ShibainuQAQ/FPGA/开发过程记录.md

# 开发过程记录

> 本作品从零开始推进，**全部开发过程以 Git 提交留痕**：
> **Gitee 主仓库：<https://gitee.com/shibainu1145/fpga>**（`master` 分支；2026-10-08 至 2026-10-31 共 **140 余次提交**，本文件本身也是一次提交）。
> 克隆后执行 `git log --oneline --date=short --pretty='%ad %s'` 即可逐条核对下文的每一次问题定位、方案迭代与实测修正。
> 本文件是这些提交的**按日期摘要**，方便快速浏览；两者内容一致，无事后美化。

---

## 1. 项目概况

| 项 | 内容 |
| --- | --- |
| 作品 | 基于 Zynq-7020 的全数字控制同步 Buck 变换器 |
| 主电路 | 24 V 输入 → 5 V / 0–3 A 输出，200 kHz 同步 Buck |
| 数字控制 | FPGA 内 DPWM（200 MHz，分辨率 5 ns）、12 位 ADC 采样、2P2Z 数字补偿、两级保护 |
| 开发周期 | 2026-10-08 ～ 2026-10-31（24 天，其中 14 天有提交，合计 140 余次） |
| 交付物 | 技术文档（201 段 / 5 表 / 25 图 / 33 页 PDF）、原理图与 PCB、BOM/Gerber/网表、FPGA 工程、演示视频 |

开发节奏是「**当天有结论就当天提交**」，所以提交密度不均匀：设计和审图阶段一天几十次，等板、等元件、现场联调的日子没有提交——那些天的工作成果体现在次日的文档与实测数据里。

---

## 2. 按日期总览

| 日期 | 提交数 | 当天主题 |
| --- | ---: | --- |
| 10-08 | 5 | 工程启动：选题冻结、ALINX AX7020 开发板锁定、XDC 模板与接口表 v1.0 |
| 10-09 | 25 | 功率级分区设计：A 区（输入滤波/保护）、B 区（辅助电源）、C 区（Buck 功率级）、D 区（栅极驱动）逐区元件清单与引脚级接线 |
| 10-10 | 60 | 原理图逐区绘制（E～I 区）+ 网表/BOM 逐项校验，12 次导出复核 |
| 10-11 | 8 | 铜宽分层、地平面分域、元件分层规范、BOM 定案、投板前检查 |
| 10-12 | 5 | 定板下单（**120.19 × 86.28 mm**）、报告骨架按竞赛模板生成 |
| 10-14 | 3 | 报告章节审阅、OVP 阈值标定表、DPWM 分辨率表述修正、FPGA 框图与 ADC 采样相位图 |
| 10-16 | 2 | AD9226 实测操作单、反馈分压比回归 0.39 |
| 10-17 | 1 | ADC 实测灵敏度判定、反馈极性与 OVP 瞬态取舍 |
| 10-18 | 5 | 板上电交接单（含停止条件）、整板极性复核（**4 只电解反装**）、上电过载诊断、报告插图 |
| 10-19 | 7 | 仓库公开化整理（01–05 目录）、闭环联调准备清单、提交倒排计划 |
| 10-26 | 7 | 实测数据集中回灌报告：死区 200 ns、ADC 416 码/V、fc/PM 锁定、ILA 死区图、两份测试台差异定位、**撤回对 9.4 V 的误判** |
| 10-29 | 6 | 工作区迁移、报告新增 §3.6「实测暴露的不足与下一版改进」、图 3-9 按证据删减 |
| 10-30 | 11 | README 指标口径对齐、25 张图正文引用补齐、改板清单 v3、开发留痕入口；**完整 RTL 与上板 XDC 入库**（四模块 + 24 条引脚约束）、报告 OVP/PS 侧口径更正 |
| 10-31 | 1 | **Vivado IP 配置入库**（`clk_wiz_0` / `ila_0` 的 `.xci` + ILA 重建脚本，路径改为可参数化）、README 依赖说明随之更新 |

> 无提交的日子（10-13、10-15、10-20～10-25）是等板/等元件与现场整机联调期，文档整理集中在有结论时一次提交，不是空转。

---

## 3. 阶段与关键节点

### 阶段一：方案冻结与功率级分区设计（10-08 ～ 10-09，30 次提交）
- 锁定主电路拓扑（同步 Buck）、开发板（AX7020）、引脚与网络命名契约（`24V_BUS`/`GND`/`HO`/`LO`/`SW` 等），接口表冻结 v1.0。
- 把整板拆成 A～I 九个功能区，逐区产出**元件清单 + 引脚级接线 + 布局要点**，而不是先画图后补文档。
- 关键决策：NMOS 连接拓扑按引脚级（含体二极管、散热片电位、热环路）画清楚后才动原理图；栅极驱动选 IR2110（DIP-14，含自举）。

### 阶段二：原理图绘制、网表校验与 BOM 定案（10-10 ～ 10-11，68 次提交）
- 每画完一个区就**导一次网表做程序化校验**（单脚网、悬空元件、元件数与网数），校验通过才关闭该区。
- 期间拦下两类致命错误（见 §4 案例 1、2），并把「导出后必跑校验清单」固化为流程。
- BOM 逐行核对 LCSC 编号与封装，修掉 9 个料号错列、2 个型号错件、R4–R16 漏填等问题。
- 10-12 定板下单，尺寸 120.19 × 86.28 mm。

### 阶段三：报告骨架与设计文档（10-12 ～ 10-17，11 次提交）
- 技术文档直接**从竞赛模板生成**（页眉 Logo、页脚页码、样式全部继承），后续每次重建都不破坏版心纪律。
- 报告插图由「清单驱动」：脚本按图号匹配候选文件名，缺图留红字占位，不出现「图文不符」。
- 10-14 修正一处表述错误：DPWM 分辨率写作 5 ns 而非 20 ns；补 FPGA 内部框图与 ADC 采样相位图。

### 阶段四：板上电、排故与闭环准备（10-18 ～ 10-19，12 次提交）
- 焊前做**全板极性复核**，查出 4 只电解电容封装极性与原理图相反（案例 3）。
- 上电按交接单执行，遇到恒功率特征的过载（案例 4），定位到 3V3 供电冲突。
- 输出闭环联调准备清单，明确唯一缺口是电压采样缓冲（案例 8 的前置）。

### 阶段五：整机闭环联调与实测（10-20 ～ 10-25，仓库静默）
- 这一周在现场完成闭环上板：软启动、2P2Z 数字补偿、两层保护、ILA 与示波器双通道实测。
- 数据没有当场上库，10-26 一次性回灌（案例 5、6、7）。

### 阶段六：实测数据回灌与报告定稿（10-26 ～ 10-31，25 次提交）
- 把实测结果与仿真、解析模型三方对齐：死区 200 ns、ADC 416 码/V、fc 6.98 kHz、PM 82.6°（设计）/ 83.9°（仿真）/ 83.5°（解析）。
- 建立「四套冲突数字」的处理规则：**以能给出测量方法与波形的那个数为准**，其余标注口径或直接删除。
- 报告新增 §3.6 专章写「实测暴露的不足与下一版改进」，不做选择性披露。
- 10-29 图 3-9（输出纹波与负载阶跃）在数据审查后被删除——理由见案例 9。
- 10-30 **完整 RTL 与上板 XDC 补入仓库**：四个模块（DPWM / ADC 接口 / 2P2Z / 顶层）按上板原始文件入库，`xvlog` 编译通过、DPWM 五项回归全过；`dpwm_top.xdc` 24 条引脚约束覆盖顶层全部 13 个端口。同时把「OVP 动作点未实测」「PS 侧监控本版未实现」两处过度声称改回事实表述。
- 10-31 **Vivado IP 配置补入仓库**：`clk_wiz_0`（50 → 200 MHz）与 `ila_0`（6 探针 / 深度 2048）的 `.xci` 以及 ILA 重建脚本 `build_ila.tcl` 入库，脚本的工程路径改为「命令行参数 → 环境变量 → 当前目录」三级回退，不再是某个人的本机绝对路径。至此**仓库自带可综合所需的全部输入**：RTL + 引脚约束 + IP 配置 + 回归测试台。

---

## 4. 典型问题与解决（均可在提交历史中查到原文）

**案例 1：网表里 24 V 与 GND 被短接（10-10 00:37）**
一次导出后程序化校验报「24V 与 GND 合并」——铜箔层实为死短路。原因是一个电源网络被误接到地网络。
处置：修正接法，并把「导出后必查电源—地是否短接」列为硬性检查项，此后每次导出必跑。

**案例 2：自举电容被短路，MOSFET 无法开通（10-10 14:25）**
IR2110 的 VB 脚与 SW 脚被画成同一网络，自举电容两端等电位，浮地驱动失效。
处置：拆出独立 `VB` 网络（4 个成员：自举二极管阴极、自举电容正极、VB 脚、无其他连接），并复核自举二极管阳极接 12 V。

**案例 3：4 只电解电容封装极性与原理图相反（10-18 21:28）**
焊前逐颗比对丝印与封装库，发现 4 只电解电容的封装极性画反。
处置：全板极性复核表 + 焊装顺序改为「先极性件后非极性件」；报告把这条写进「不足与改进」。

**案例 4：上电即过载，特征指向 3V3 冲突（10-18 18:04）**
恒功率特征的过流说明不是短路而是负载异常，最终定位到 3V3 由板上与外部同时供给形成对冲。
处置：明确 3V3 为**板输入**，补电源方向表与两条供电规则。

**案例 5：死区从 20 ns 改成 200 ns（10-26）**
最初按「越小越好」取 20 ns，实测开关瞬间出现约 300 mA 直通电流。
处置：死区 40 个 5 ns 计数 = **200.0 ns**（ILA 读数 40×5 ns 与示波器 200.000 kHz 双证据互证），并把「死区不得小于 200 ns」写进改板清单与 RTL 约束。

**案例 6：保护响应时间口径被拆成三段（10-26 20:50）**
早期把保护响应笼统写成「10–15 ns」，与实测的端到端约 1.0 µs 矛盾。
处置：拆成 **逻辑封波 2 拍 = 10 ns → 数字链路 58 ns → 含 1 µs 数字滤波的端到端 ≈1.0 µs → 驱动级再 +95~120 ns** 四段，各自给测量条件。

**案例 7：撤回对「9.4 V 启动过冲」的误判（10-26 22:48）**
曾把一份仿真 CSV 的 9.37 V 峰值当成真实启动过冲。复核发现该 CSV 的软启动参数有误（**40 µs 就到 5 V**，是设计的 16 倍快），该数据不能用来画启动过程。
处置：公开撤回该结论；改用示波器实测启动波形（峰值 **6.56 V**，+24 %），并新增图与表行记录。这是本项目「数据自纠」的标志性一次。

**案例 8：反馈采样阻抗不匹配（10-17 ～ 10-18）**
12 位 ADC 模块输入阻抗 50 Ω，而分压网络戴维南等效约 10.6 kΩ，直接相连会把 1.70 V 拉到 0.047 V。
处置：本版临时改为板外 220 Ω / 2.2 kΩ 分压（比值 ≈0.2017，零点 2048，实测 REF_CODE 2453）；下一版加单位增益跟随器。

**案例 9：删掉一张「凑不出来」的图（10-29 16:58）**
原计划的图 3-9「输出纹波与负载阶跃响应」无法用现有数据画出：仿真导出步长 5 µs（每个开关周期仅 1 点），**不足以还原 200 kHz 纹波**；负载阶跃数据里还含阶跃首点的数值伪迹。
处置：直接删除该图并整体前移图号，纹波只用实测值（60 mV，短地弹簧测量法）+ 表格表述。宁缺一张图，不留一处图文不符。

---

## 5. 最终口径速查（与报告、答辩一致）

| 项 | 数值 |
| --- | --- |
| 开关频率 / 周期 | 200.00 kHz / `PERIOD_CY` = 1000（200 MHz 计数） |
| DPWM 分辨率 / 死区 | 5 ns；死区 40 计数 = **200.0 ns**（高侧脉宽 980 ns、低侧 3980 ns） |
| 占空比（三工况） | 闭环带载 2 Ω **22.6~23.0 %**；闭环空载 **16.8 %**；开环 15.6 % / 76.6 % |
| ADC | AD9226，12 位，**416 码/V**，零点 2048，`REF_CODE` 2453，板外分压比 0.2017 |
| 数字补偿 | 2P2Z，Q14 定点；B0=624、B1=−1121、B2=504、A1=−22272、A2=+5888 |
| 环路 | fc ≈ 6.98 kHz；PM 82.6°（设计）/ 83.9°（仿真）/ 83.5°（解析，图 2-15） |
| 保护 | 逻辑封波 10 ns → 数字链路 58 ns → 含 1 µs 滤波端到端 ≈1.0 µs → 驱动 +95~120 ns |
| 稳态实测 | 5.00 V，ADC 码 2453 与 `REF_CODE` 一致（误差 0 码），纹波 60 mV，空载输入电流 46 mA |
| 时序 | WNS +0.581 ns |
| 仿真 | 稳态 4.9946 V、纹波 14.9 mV；负载 0.7→3 A 跌落 15.3 %、3→0.3 A 过冲 20.2 %，恢复 4.0 / 2.5 ms |

---

## 6. 已知不足（如实披露）

1. **启动过冲**：实测峰值 6.56 V（+24 %），超出 OVP 设计参考 5.76 V；因尖峰短于 1 µs 数字滤波窗未触发保护。根因是软启动只做参考码线性斜坡、无占空比斜率限制。
2. **OVP 动作点未实测**：分压比换算的设计目标 5.76 V，实际动作点本版从未测量（流传的「6.34 V」是按基准与分压比反推，不是实测）；下一版逐台实测后重标定分压电阻，并把 OVP 阈值 / ADC 满量程 / OTR 三项联动校核。
3. **负载阶跃仅有仿真结果**：实测负载阶跃未完成，报告按「仅仿真」标注。
4. **效率与温升未测**：功率通路存在端子与铜箔线损（等效 ≈0.19 Ω），是效率的主要瓶颈，已列入下一版改板。
5. **硬件 12 条改进**：完整清单与优先级见 `05-硬件与采购/改板清单-v3-20261030.md`（该目录随 Gitee 主仓库留痕，公开交付快照不含；P0 四条：电压采样加跟随器、取样点移负载侧、输出端子与铜宽、电解封装极性）。

---

## 7. 如何核对与复现

```bash
git clone https://gitee.com/shibainu1145/fpga.git
cd fpga
git log --oneline --date=short --pretty='%ad %s'      # 140 条提交，即本文件的数据来源
git log --stat                                        # 看每次提交改了哪些文件
```

- 报告生成：`04-技术文档/工具/生成脚本.py`（重建 docx）
- 报告校验：`04-技术文档/工具/校验.py`（版心、插图宽度、表宽、页眉页脚、章节完整性）
- 硬件布局图生成：`05-硬件与采购/工具/`（随 Gitee 主仓库留痕）
- EDA 导出校验：`03-EDA导出/工具/`

技术文档、原理图素材、BOM、Gerber、网表、FPGA 工程与本记录同版本提交，可直接对照阅读。
