ShibainuQAQ/FPGA/01-项目说明/01-作品简介.md

# 作品简介

**作品名称**：基于 FPGA 的全数字控制同步 Buck 降压电源

**一句话简介**：面向精密仪器低压供电轨（传感器与模拟前端的数字预稳压级）的 24 V→5 V/3 A 全数字同步 Buck 变换器，调制、采样、补偿与保护全部由 FPGA 可编程逻辑实现。

---

## 一、作品概述（约 400 字）

本作品面向“对供电稳定性要求高、单路功率在数十瓦以内”的精密低压负载，作为其**数字预稳压级**。这类负载（例如半导体制造与精密测量装备中传感器、模拟前端的供电轨）通行“开关前级＋线性后级”的两级架构：开关级负责效率、瞬态响应与故障保护，后级以 π 型滤波与 LDO 把纹波压到毫伏级，直流精度由电压基准决定。

本作品以 AMD Zynq-7020 的可编程逻辑（PL）为核心，设计并实现一台 24 V 输入、5 V/0–3 A 输出的全数字控制同步 Buck 变换器。与“FPGA 仅作 PWM 发生器”的常见做法不同，本作品把开关频率、死区、保护、采样时序与闭环补偿全部置于 PL 内：200 MHz 时钟域产生 200 kHz 互补 PWM（时间分辨率 5 ns、占空比步进 0.1%），并插入 200 ns 数字死区；输出电压经分压、电感电流经 10 mΩ 分流电阻与电流检测放大器（50 V/V）调理后，由 12 位 AD9226 以 2 MHz 与 PWM 周期严格同步地在“安静窗”内采样，送入片内 2P2Z 数字补偿器构成闭环；过流与过压由硬件比较器检测，FPGA 的数字链路以 58 ns 固有延迟（含 1 µs 数字滤波后端到端约 1.0 µs）逐周期封锁 PWM 并闩锁至人工复位。

作品的价值不仅在功能实现，更在于**可验证的工程方法**：原理图阶段以导出网表逐网络逐引脚核对（终版 51 网络、零单脚网络、零悬空元件），打板前检查层叠与孔位，装配前核对全部有极性器件；并搭建“被控对象—ADC—采样接口—补偿器—DPWM”的端到端 RTL 闭环仿真，据其结果为反馈通道定标。上板后闭环输出 5.00–5.01 V、稳态误差 0 码、纹波 60 mV（短地弹簧实测）；启动过冲 6.56 V 等不足亦如实记入报告。全程 24 V 以下低压验证，兼顾安全与可重复性。

---

## 二、主要技术指标

| 项目 | 指标 |
|---|---|
| 输入 / 输出 | 24 V → 5 V / 0–3 A（15 W） |
| 开关频率 | 200 kHz（周期 5000 ns；实测 200.00 kHz） |
| DPWM 时间分辨率 | **5 ns**（占空比步进 0.1%） |
| 数字死区 | **200 ns**（40 × 5 ns，高低侧双向，计数器统一产生） |
| 保护响应 | 数字链路 **58 ns**（无滤波）；含 1 µs 数字滤波后端到端 **≈1.0 µs**；驱动级再叠加 95~120 ns |
| 保护机制 | 硬件 OCP/OVP 比较器 + 逐周期封锁 + 故障闩锁 |
| ADC | AD9226 12 bit / 65 MSPS，2 MHz 与 PWM 同步采样；实测灵敏度 **416 码/V**、零点 2048 |
| 电流采样 | 10 mΩ 分流 + INA180A2（50 V/V）= 0.5 V/A |
| 电压采样 | 本版板外 220 Ω／2.2 kΩ，分压比 **0.2017**、参考码 2453（板内 R7/R8/R9 可调 0.25–0.40，下一版启用） |
| 控制算法 | 2P2Z 数字补偿器（Q14 定点、10 拍流水 MAC） |
| 环路指标 | fc **6.99 kHz**、PM **83.5°**（解析模型，Td 7.5 µs / f0 6.79 kHz / Q 3.91） |
| 闭环仿真 | 稳态 4.9946 V、纹波 14.9 mV、负载跌落 15.3 %、过冲 20.2 %、恢复 4.0／2.5 ms |
| 闭环实测（上板） | 5.00–5.01 V、ADC 码 2453 与参考码一致（**误差 0 码**）、纹波 60 mV、带载 2 Ω 占空比 22.6~23.0 % |
| 启动过冲（实测） | 峰值 **6.56 V**（+24 %），持续时间短于 1 µs 滤波窗口未触发保护，2 ms 内恢复 5 V |
| 功率板 | 120.19 × 86.28 mm、2 层、1 oz、4 × M3 |

---

## 三、主要特点

1. **全数字控制**：调制、死区、保护、采样时序与补偿全部由 PL 实现，参数可通过 RTL 调整，
   重复性好、不受温漂影响。
2. **采样相位与功率级对齐**：电流采样仅在低边管导通期间有效，采样点由 RTL 精确落在该窗口内，
   并避开开关瞬态。
3. **三层保护**：硬件比较器快速检测、FPGA 逐周期封波（数字链路 58 ns，含 1 µs 滤波约 1.0 µs）、
   故障闩锁与人工复位，在功率器件受损之前切断驱动。
4. **仿真驱动设计**：以端到端 RTL 闭环仿真校核环路，并据此纠正了采样通道的关键假设
   （ADC 灵敏度实测 **416 码/V**、零点恰为 **2048**），重新核定了反馈余量与补偿器定标。
5. **面向开关电源的板级纪律**：开关环路面积最小化、功率地与信号地分域单点星形汇接、
   电流采样开尔文连接、按载流分级的铜宽与多过孔换层。
6. **面向精密供电的工程定位**：以“开关前级＋线性后级”两级架构对接传感器与模拟前端供电轨，
   实测不足（纹波 60 mV、启动过冲 +24 %、负载阶跃恢复 4 ms）与改进方向完整记录于报告 §3.6。
