ShibainuQAQ/FPGA/03-EDA导出/网表核对-20261009.md

# 网表核对记录 · A/B/C 三区（2026-10-09 23:41）

> 源文件：`Netlist_DC-DC电源_2026-10-09.tel`（立创EDA 导出，Telesis 格式）
> 方法：**逐网络、逐引脚**对照《接口表① 信号接线表 v1.0》+ 各区要点文档（比看截图可靠）
> **结论：✅ A/B/C 三区通过**——24V 输入、两级辅助电源（12V/5V）、Buck 功率级全部闭环

---

## 一、关键网络逐条核对

| 网络 | 网表成员 | 判定 |
|---|---|---|
| `24V` | C1.1 C2.1 C3.2 C4.2 C11.2 C23.2 D1.2 LED1.2 Q1.2 U1.1 | ✅ 输入电容组 + 防反输出 + 两只 IC 输入 + 上管漏极 |
| **半桥 `SW`** | L3.1 Q1.3 Q2.2 R_gs1.1 | ✅ 上管源 / 下管漏 / 电感 / 上管下拉，一处不错 |
| `12V` | C5.2 C6.2 C9.2 C12.2 C14.2 L1.2 LED2.2 U1.4 U2.1 | ✅ 含 U1.FB、U2.VIN（级联）；**不含任何二极管** |
| `5V` | C7.2 C8.2 C10.2 C13.2 L2.2 LED3.2 U2.4 | ✅ 含 U2.FB；**不含任何二极管** |
| `VOUT` | C15.2 C16.2 C17.2 C18.2 C19.2 C20.2 L3.2 | ✅ 与 `5V` 完全独立（未混网） |
| `GND` | 40 个引脚（J1.2 / R_shunt.1 / U1·U2 的 3·5·6 脚 / 两只续流管阳极…） | ✅ |
| `ISENSE_P` | Q2.3 R_gs2.1 R_shunt.2 | ✅ 采样电阻上端 + 下管源极 + 栅源下拉 |
| `HO` / `LO` | R_g1.2 / R_g2.2 | ✅ 驱动接口只到栅极电阻 |
| U1 开关节点 | **D2.1** L1.1 U1.2 | ✅ 续流管阴极在开关节点 |
| U2 开关节点 | **D3.1** L2.1 U2.2 | ✅ 同上 |

## 二、逐管核对（引脚级）

### U1（LM2596HC5-12，固定 12V）
| 脚 | 网络 | 判定 |
|---|---|---|
| 1 VIN | `24V` | ✅ |
| 2 OUT | 开关节点 | ✅ |
| 3 GND | `GND` | ✅ |
| 4 FB | `12V`（输出） | ✅ 固定版正确用法 |
| 5 ON/OFF | **`GND`** | ✅ 常开（接电源=关断） |
| 6 GND(tab) | `GND` | ✅ |

### U2（LM2596SX-5.0，固定 5V）
| 脚 | 网络 | 判定 |
|---|---|---|
| 1 VIN | `12V` | ✅ 级联正确 |
| 2 OUTPUT | 开关节点 | ✅ |
| 3 GND | `GND` | ✅ |
| 4 FB | `5V`（输出） | ✅ |
| 5 ON/OFF | **`GND`** | ✅ |
| 6 GND(tab) | `GND` | ✅ |

### Q1 / Q2（IRLZ44N）
| 管 | 栅极（含 10Ω + 10k） | 漏极 | 源极 | 判定 |
|---|---|---|---|---|
| Q1 上管 | `R_g1` + `R_gs1` | `24V` | **`SW`** | ✅ |
| Q2 下管 | `R_g2` + `R_gs2` | **`SW`** | `ISENSE_P`（R_shunt 上端） | ✅ |

### 续流二极管
| 管 | 阴极 | 阳极 | 判定 |
|---|---|---|---|
| D2 | U1 开关节点 | `GND` | ✅ |
| D3 | U2 开关节点 | `GND` | ✅ |

> 本库二极管符号「脚 1 = 阴极」由用户原版 D3 反推确认（一开始就是对的）。

## 三、与接口表登记名的一致性

`24V` ✅ `12V` ✅ `5V` ✅ `VOUT` ✅ `GND` ✅ `HO` ✅ `LO` ✅ `SW` ✅ `ISENSE_P` ✅
—— 全部与冻结登记表一致，**无自创别名**。

## 四、遗留项（不影响封口）

1. A 区未放 `TP1/TP2/TP3` 测点（可选，便于 bring-up 量电压）；
2. 电解电容在原理图上用的是**无极性符号 + `C0603` 占位封装**（C11/C12/C14/C23）→ 实装前确认符号/实物的 `+` 朝电源正极；
3. 封装需与实物对齐：`L0603` → 实际直插电感；`C0603` → 实际电解；C1/C2 为 SMD 6.3mm 而采购件是直插 6×8mm（洞洞板手焊无碍，**照网表下单会买错**）；
4. 保险丝已决定不装 → 口径已同步为"两道防线"，**上电必须用限流电源**。
