ShibainuQAQ/FPGA/02-软件/FPGA工程/接口表/1-信号接线表.md

# 功率板 — FPGA 信号接口定义（v1.5）

> **适用范围**：功率板 H 区 `J3`（2×13 排针）↔ FPGA 板 `J10`（2×20 排针）；
> `J4`（ADC 模块，2×13 排针）；`J5` / `J6`（模拟测试点）。
> **版本**：v1.5（2026-10-11 定稿）｜ **本文件是接口的唯一依据**：跨区连接只使用本文定义的网络名与针号。

## 一、PWM 通道（FPGA → 栅极驱动）

| 信号 | 路径 | 方向 | 电平 | FPGA 引脚 | 功率板端子 | 备注 |
|---|---|---|---|---|---|---|
| `pwm_h` | FPGA → 74HCT245 → IR2110 `HIN` | out | 3.3 V → 5 V | **W18**（板级网名 `IO1_1P`） | HIN | v1 端口；高 = 上管开通 |
| `pwm_l` | FPGA → 74HCT245 → IR2110 `LIN` | out | 3.3 V → 5 V | **W19**（板级网名 `IO1_1N`） | LIN | v1 端口；高 = 下管开通 |
| `GND` | FPGA ↔ 驱动 ↔ 功率级 | — | 0 V | 多根 | GND | **单点共地**；功率走线与模拟走线分开 |

**为什么用 74HCT245**：IR2110 逻辑电源 VDD = 5 V 时输入高门限约 0.7×VDD ≈ 3.5 V，
FPGA 的 3.3 V 直驱处于边缘。245 把电平抬到 5 V 并增强驱动。BOM 第 6 项已含。

### 上电安全要求

**74HCT245 的 A 侧（FPGA 侧）三根线各加 1 只 10 kΩ**：`PWM_H` / `PWM_L` **下拉到 GND**；`SD` **上拉到 `3V3`**（v1.1 变更 ③，硬件侧 10/09 提案，✅ **数字控制侧 10/10 深夜已确认**：上电/未配置期间 `SD=1` → 驱动器整体封锁，比"靠 HIN/LIN 同时为 0"多一层保险；配置完成后 FPGA 主动拉低使能，对其 RTL 零影响）。

- 目的：FPGA **未配置 / 复位期间**，245 的输入不能悬空，否则输出电平不确定 → 栅极可能乱动 → **直通炸管**；
- 加了 10 kΩ 下拉后：上电到配置完成之前，245 输入恒低 → IR2110 的 HIN/LIN 恒低 → **HO = LO = 0**，栅极必为低；
- 10 kΩ 对 FPGA 输出几乎无负载（3.3 V / 10 kΩ = 0.33 mA），不影响驱动能力。

**为什么 `SD` 改成上拉（v1.1 变更 ③，硬件侧 2026-10-09）**：三根都下拉时，上电期间 `SD = 0` = 驱动器**使能**，安全性全靠"`HIN`/`LIN` 同时为 0"这一条；把 `SD` 改为**上拉到 `3V3`** 后，上电/复位期间 `SD = 1` = **驱动器整体封锁**，即使 `HIN`/`LIN` 有毛刺也出不来 —— 多一层保险。FPGA 配置完成后主动把 `SD` 拉低使能，正常功能不受影响。**电阻还是同一只 10 kΩ，只是改接到 `3V3`。**
（数字控制侧若坚持三根都下拉，**不影响安全**——`HIN`/`LIN` 也是 0；但推荐改上拉。）

## 二、故障通道（LM393 → FPGA → 驱动）

### 真值表（极性明确）

| `FAULT_N`（板级网名） | `protect_raw`（同步后） | `SD`（→ IR2110） | HO / LO | 说明 |
|---|---|---|---|---|
| 1（正常） | 0 | 0 | 受 HIN / LIN 控制 | 正常工作 |
| 0（过流） | 1 | 1 | 恒为 0 | 逐周期封波 **＋** 驱动关断；`SD` 闩锁到复位才解除 |

**`SD` 的极性依据**：硬件侧已核 **英飞凌原厂 IR2110 手册** —— `SD` 高电平封波、内部有下拉、悬空 = 使能。
（网上二手页面写 "active low" 的不要参考。）

### 接线与实现

| 信号 | 路径 | 方向 | 电平 | FPGA 引脚 | 端子 | 备注 |
|---|---|---|---|---|---|---|
| `FAULT_N` | LM393 `OUT` → FPGA | in | 开集 + **3.3 V 上拉（10 kΩ，BOM #24）** | **R14**（板级网名 `IO1_2N`） | FAULT | **0 = 过流**；数字控制侧在 FPGA 内部也开了上拉（台面悬空不误触发） |
| `SD` | 顶层 wrapper → 74HCT245 → IR2110 `SD` | out | 3.3 V → 5 V | **P14**（板级网名 `IO1_2P`） | SD | **0 = 正常，1 = 关断**（A 侧 10 kΩ **上拉到 3V3**，见第一节 v1.1 变更 ③） |
| — | LM393 供电 | — | 5 V（LM2596） | — | 5V | 开集只拉低，上拉到 3.3 V 对 FPGA 安全 |
| — | OCP 阈值 | 3296 多圈电位器 10 kΩ | — | — | — | 现场可调 |

**顶层 wrapper 里的处理（已在 `top/dpwm_top.v` 实现并仿真验证 7/7）**：

```verilog
input wire FAULT_N;                        // 0 = 过流（异步输入）

reg [1:0] sync_ff;                         // 2FF 同步器：异步输入跨时钟域必加
always @(posedge clk_200m or negedge rst_n)
    if (!rst_n) sync_ff <= 2'b11;          // 复位取"无故障"，避免上电误闩锁
    else        sync_ff <= {sync_ff[0], FAULT_N};

wire protect_raw = ~sync_ff[1];            // 1 = 过流（已同步）

reg protect_latched;                       // 闩锁：复位/PS 才清
always @(posedge clk_200m or negedge rst_n)
    if (!rst_n)           protect_latched <= 1'b0;
    else if (protect_raw) protect_latched <= 1'b1;

assign SD          = protect_latched;      // 0 = 正常，1 = 关断（驱动级，闩锁）
// dpwm_core 例化： .fault_i(protect_raw)  ← 逐周期封波用【原始】故障
```

**这是两级保护**（硬件侧 2026-10-08 定）：
- **逐周期**：`protect_raw` 直接进 DPWM 的 `fault_i` → 超限即封、下周期重试；
- **闩锁**：`protect_latched` 驱动 `SD` → 一旦过流就把驱动关到复位为止。

> 注意一个刻意的设计后果：**闩锁之后 DPWM 仍会继续发 PWM**（它按"原始故障"逐周期工作），
> 但 IR2110 被 `SD` 关断、HO/LO 恒低。所以"闩锁"这个状态要看 `SD`，不要看 `pwm_h`。这是有意设计，不是 bug。

### 关于 3.3 V 上拉取 10 kΩ 的取值说明

我 10-07 曾建议"别用 4.7 kΩ，会拖慢保护边沿"——**这个说法不准确**，更正如下：

- **过流是 LM393 主动把线拉低**，下沿由比较器的灌电流驱动（LM393 可灌 16 mA），**快**；
- 上拉电阻只影响**故障恢复的上沿**（过流消失、线上被拉回高电平），10 kΩ + ~15 pF 约百 ns 量级；
- 也就是说 **10 kΩ 不影响保护的响应速度**，只影响"恢复"这段（而本方案闩锁后本来就要复位才能恢复）。
- 结论：**BOM #24 的 10 kΩ 够用，不必改 1 kΩ。**

## 二·补、与原理图 A–I 分区方案的对应关系

| 模板 H 区的信号 | 方向 | 冻结 v1 里对应什么 | 状态 |
|---|---|---|---|
| `PWM_H` / `PWM_L` | FPGA 出 → D 区 | `pwm_h` / `pwm_l` ✅ | 一致（只是大小写） |
| `FAULT_N` | F 区（LM393）→ FPGA 入 | `fault_i`（经同步 + 取反）✅ | ✅ 已定；板级网名与顶层端口同名 |
| **`SD`** | **FPGA 出 → D 区（IR2110 SD 脚）** | ❌ v1 没有 → **顶层 wrapper 生成** ✅ | ✅ 2026-10-08 批准方案 (a)；真值表见第二节 |
| `ADC_D[11:0]` + `OTR` | I 区 → FPGA 入 | ❌ 还没做（10/15 的活） | ✅ 已定：**12 位全并行 + OTR，不串行化** |
| `ADC_CLK` | **FPGA 出 → AD9226** | ❌ | ✅ 已定：**FPGA 提供，2 MHz**（200 MHz ÷ 100） |
| 3V3 / GND | 核心板 → 功率板 | — | 3V3 **仅限小信号 < 100 mA**；只共地、不共 5 V |
| （模板未体现）`clk` / `rst_n` / `duty_i` | — | v1 有 | `clk` = 板载 50 MHz 倍频；**`rst_n` = 核心板板载按键**；`duty_i` 来自 PS（10/15 后） |

## 二·补2、跨区网络命名规范（跨区连接只用下列网络名）

> 由来：10/9 画 A/B 区时发现同一根 24V 母线在 A 区写成 `24V_BUS`、在 B 区写成 `VCC`——电气上巧合能连通，但**名字必须统一**，否则换人画/改板必出错。

| 网络名 | 含义 | 出现位置 | 备注 |
|---|---|---|---|
| **`24V`** | 24V 功率母线（防反二极管之后） | A 区出 → B 区进 → C 区进 | **以图纸为准的正式名**（早期文档写作 `24V_BUS`，同义；A/B/C 区图纸统一用 `24V`）。⚠️ **不要叫 `VCC`/`VIN`**：本作品里 IR2110 的 `VCC` 是 **12V 门驱动电源**、5V 逻辑电源也常被叫 VCC，重名会直接误导接线 |
| **`12V`** | 辅助电源 12V（→ IR2110 `VCC` 门驱动 + 自举） | B 区出 → D 区进 | |
| **`5V`** | 辅助电源 5V（逻辑） | B 区出 → D/F 区进 | |
| **`3V3`** | **核心板来的 3.3V（本板是【输入】，板上没有 3.3V 稳压器）**，实测只取 **≈1.1 mA** | **FPGA 板 → H 区（J3.20）→ 功率板** | 见下方「供电方向总表」；另经 `J4.17` 转给 ADC 模块（⚠️ 可选，见注）|
| **`GND`** | 地（**物理上分功率地/控制地，只在总星点汇合**） | 全区 | 原理图里同名即同网络；星地是实装纪律 |
| **`PWM_H` / `PWM_L` / `SD`** | FPGA → 驱动级 | H 区 → D 区 | SD：0=正常、1=关断 |
| **`FAULT_N`** | LM393 → FPGA（**0 = 过流**） | F 区 → H 区 | |
| **`VOUT`** | **功率级输出 5V（0–3A）** | C 区出 → E 区取样 / G 区测试 / 负载 | ⚠️ **绝不能叫 `5V`**：`5V` 已被 B 区辅助逻辑电源占用，重名会把功率输出与逻辑电源短接 |
| **`HO` / `LO`** | IR2110 输出 → 10Ω 栅极电阻 → 功率管栅极 | D 区 → C 区 | **以图纸为准的正式名**（早期文档写作 `GATE_H`/`GATE_L`，同义）；与 IR2110 引脚同名，沿用 `SD` 的命名哲学 |
| **`SW`** | 半桥开关节点（Q1 源 / Q2 漏 / 电感前端） | C 区内部 | 走线短、够载流、**不铺大面积铜** |
| **`ISENSE_P` / `ISENSE_N`** | 采样电阻两端（开尔文成对走线） | C 区 → F 区 | 从 R_shunt 焊盘根部引出，远离 SW 与电感 |
| **`VSENSE`**（✅ 数字控制侧已确认） | E 区分压+滤波后的电压信号 → ADC 模拟输入 | **E 区 → I 区** | 2026-10-10 画 E 区时确定；**ADC 模块未买，分压比暂按 0–2 V 设计（可调 1.25–2.00 V）**，见《E 区排布与接线要点-20261010.md》 |
| **`ISENSE`**（✅ 数字控制侧已确认） | F 区 INA180A2 输出（+ LM393 比较）→ ADC 模拟输入 | **F 区 → I 区** | 0–2 V 对应 0–4 A；与 `ISENSE_P/N` 区分：**`ISENSE` 是放大后的单端信号** |
| **`ADC_D[11:0]` / `OTR` / `ADC_CLK`** | AD9226 接口 | I 区 ↔ H 区 | 10/15 后接 |

**规则**：跨区连接只用上表名字；**区内小节点**（如 A 区的 `24V_IN`、`24V_PROT`）随便叫什么，不出区。

### 📌 二·补2·附 供电方向总表（2026-10-18 补，**看方向别看名字**）

| 网络 | **方向** | 产生/来源 | 去向 | 电流量级 |
|---|---|---|---|---|
| **`24V`** | **输入** | `J1` 外部 24 V | A 区滤波 → B/C 区 | 平均 0.8 A，开关峰值 3 A+ |
| **`12V`** | **板内产生** | `U1`（LM2596-12，由 24V 降压）| IR2110 `VCC` + 自举充电 | ≈50 mA |
| **`5V`** | **板内产生**（既自用也**对外输出**）| `U2`（LM2596-5.0，由 12V 降压）| 逻辑器件（245/IR2110 VDD/比较器/INA180）**+ `J4.16` → ADC 模块** | 逻辑 ≈5–15 mA；模块 150–250 mA |
| **`3V3`** | **⭐ 输入** | **FPGA 板 `J10` 的 `VCC3V3`（第 39/40 针）→ `J3` 第 20 针** | `R6`/`R12`/`R14`/`R15` 上拉与阈值 + `D5` 钳位；另经 `J4.17` 转给 ADC 模块（⚠️ 见注）| **≈1.1 mA**（R6 0.33 + R14 0.33 + R12/R15 各 0.22）|
| **`VOUT`** | 输出 | C 区同步 Buck | `J2` 端子 → 负载；E 区采样 | 0–3 A |
| **`GND`** | — | — | 全区（功率地/控制地仅在星点汇合）| — |

#### ⚠️ 两条供电纪律（务必遵守）

| # | 纪律 | 原因 |
|---|---|---|
| **1** | **`J4` 第 17 针（`3V3`）→ ADC 模块的 `3V3` 脚：先确认该脚是输入还是输出** | 若模块的 `3V3` 是**它自己 LDO 的输出**（很可能 —— 模块只需 5 V 供电即可工作），则**接上等于两个电源并联、会互灌** ✗。<br>**判定**：只给模块 5 V，万用表量模块 `3V3` 脚对 `GND` —— **≈3.3 V ⇒ 是输出 ⇒ 不要接** ✓ ／ **0 V ⇒ 是输入 ⇒ 可接** ✓ |
| **2** | **`J10` 第 2 针（`VCC5V`）不接** —— 本板与核心板"**共地不共 5 V**" | 本板 5 V 由 `U2` 自己产生；若再从核心板接 5 V，**两路电源对着顶** ✗。<br>（台架临时从 J10 取 5 V 可以，**正式联调必须改本板 `J4.16` 供 5 V**）|

## 二·补3、J10（FPGA 侧排针）引脚定义

> 来源：ALINX 官方管脚表（`AX7010_AX7020管脚.xlsx` / `管脚表-dump.txt`）＋ AX7020 原理图 V2.0 ＋ 数字控制侧实测
> **2026-10-10 晚更新三件事**：① **`EX_` 前缀定案**（见下）；② **13 根 `ADC_D[11:0]`+`OTR` 全部分配完毕，且全在 J10 一根排针上**（不用动 J11）；③ **FPGA 球号已由 硬件侧用官方管脚表原文逐条独立复核 —— 20/20 全部一致** ✅

### 关于 `EX_` 名称前缀

```
FPGA 芯片球 W18 ── 核心板内网名【IO1_1P】── RN 电阻网络(33Ω) ── 排针侧网名【EX_IO1_1P】── J10 第 11 针
```

| 用法 | 用哪个名字 |
|---|---|
| **功率板丝印 / 接线图**（对着排针） | ✅ **`EX_IO1_x`**（原理图 J10 页就是这么标的） |
| FPGA 侧（XDC、RTL） | `IO1_x`（核心板内部网名） |

> 中间那只 **33 Ω（RN 网络）** 对我们要传的信号**无影响**（200 kHz PWM、2 MHz ADC_CLK、12 位并行数据都远低于它的带宽拐点）—— 数字控制侧确认。

### 完整引脚表

| 信号 | 方向 | 功率板丝印名（定案） | FPGA 侧网名 | **FPGA 球号**（硬件侧已复核 ✅） | **J10 针号** | 约束 | 去向 |
|---|---|---|---|---|---|---|---|
| `pwm_h` | 出 | **`EX_IO1_1P`** | `IO1_1P` | **W18** ✅ | **4**（✅ **已物理实测** 18.87–19.23 kHz） | LVCMOS33 | → 245 → IR2110 `HIN` |
| `pwm_l` | 出 | **`EX_IO1_1N`** | `IO1_1N` | **W19** ✅ | **3**（✅ **已物理实测** 18.18 kHz） | LVCMOS33 | → 245 → IR2110 `LIN` |
| `SD` | 出 | `EX_IO1_2P` | `IO1_2P` | **P14** ✅ | **6** | LVCMOS33 | → 245 → IR2110 `SD`（0=正常/1=关断） |
| `FAULT_N` | 入 | `EX_IO1_2N` | `IO1_2N` | **R14** ✅ | **5**（🔶 读图，待扫） | LVCMOS33 | ← LM393 开集 + 3V3 上拉（0=故障） |
| `ADC_CLK` | 出 | `EX_IO1_3P` | `IO1_3P` | **Y16** ✅ | **8** | LVCMOS33 | → AD9226 `CLK`（2 MHz） |
| `pwm_tick` | 出 | `EX_IO1_3N` | `IO1_3N` | **Y17** ✅ | **7** | LVCMOS33 | 示波器测试点（已引出，量死区/对相用） |
| **`ADC_D0`** | 入 | `EX_IO1_4N` | `IO1_4N` | **W15** ✅ | **9** | LVCMOS33 | ← AD9226 `D0` |
| **`ADC_D1`** | 入 | `EX_IO1_4P` | `IO1_4P` | **V15** ✅ | **10** | LVCMOS33 | ← `D1` |
| **`ADC_D2`** | 入 | `EX_IO1_5N` | `IO1_5N` | **Y14** ✅ | **11** | LVCMOS33 | ← `D2` |
| **`ADC_D3`** | 入 | `EX_IO1_5P` | `IO1_5P` | **W14** ✅ | **12** | LVCMOS33 | ← `D3` |
| **`ADC_D4`** | 入 | `EX_IO1_6N` | `IO1_6N` | **P18** ✅ | **13** | LVCMOS33 | ← `D4` |
| **`ADC_D5`** | 入 | `EX_IO1_6P` | `IO1_6P` | **N17** ✅ | **14** | LVCMOS33 | ← `D5` |
| **`ADC_D6`** | 入 | `EX_IO1_7N` | `IO1_7N` | **U15** ✅ | **15** | LVCMOS33 | ← `D6` |
| **`ADC_D7`** | 入 | `EX_IO1_7P` | `IO1_7P` | **U14** ✅ | **16** | LVCMOS33 | ← `D7` |
| **`ADC_D8`** | 入 | `EX_IO1_8N` | `IO1_8N` | **P16** ✅ | **17** | LVCMOS33 | ← `D8` |
| **`ADC_D9`** | 入 | `EX_IO1_8P` | `IO1_8P` | **P15** ✅ | **18** | LVCMOS33 | ← `D9` |
| **`ADC_D10`** | 入 | `EX_IO1_9N` | `IO1_9N` | **U17** ✅ | **19** | LVCMOS33 | ← `D10` |
| **`ADC_D11`** | 入 | `EX_IO1_9P` | `IO1_9P` | **T16** ✅ | **20** | LVCMOS33 | ← `D11` |
| **`OTR`** | 入 | `EX_IO1_10P` | `IO1_10P` | **V17** ✅ | **22** | LVCMOS33 | ← AD9226 `OTR`（量程溢出） |
| （备用） | — | `EX_IO1_10N` | `IO1_10N` | **V18** ✅ | **21** | LVCMOS33 | 预留（不接） |
| `5V`（核心板那路） | — | `VCC5V` | — | — | **2** | — | ⚠️ **功率板侧一律不接**（防止两路 5 V 并起来） |
| `3V3` | 核心板 → 功率板 | `VCC3V3` | — | — | **39 / 40** | — | **仅小信号 < 100 mA**（实际用 ≈1 mA） |
| `GND` | — | `GND` | — | — | **1 / 37 / 38** | — | 接 **2–3 根**（**第 1 针就是 GND**） |

### J10 针号与 FPGA 引脚的对应关系

> 早期一版针号表取自低分辨率图片、存在整体偏差，已废止，以本文件为准。
> **真实规律：`IO1_xN` 在奇数针、`IO1_xP` 在偶数针，成对相邻** —— 见上表（**J10 针号列已是更正后的值**）。

#### ✅ 物理确认进度（2026-10-11 凌晨 · 数字控制侧《v1.5 已获物理实测确认》）

| 部分 | 状态 | 依据 |
|---|---|---|
| **`IO1_1N` = 第 3 针**（`pwm_l`） | ✅ **已物理实测确认** | 该针读 **18.18 kHz** —— 测试设计只给 `IO1_1N` 发 18 kHz |
| **`IO1_1P` = 第 4 针**（`pwm_h`） | ✅ **已物理实测确认** | 该针读 **18.87–19.23 kHz** —— 只给 `IO1_1P` 发 19 kHz |
| 两条杜邦线的物理位置 | ✅ 用户确认是**上下两排**（一奇一偶相邻对） | 与"`N` 奇 / `P` 偶"一致 |
| **其余（`SD`/`FAULT_N`/`ADC_CLK`/`pwm_tick` + 13 根 ADC + `OTR`）** | 🔶 **读图 + 算术自洽，待扫一遍** | 数字控制侧会让用户**顺着点 13 格**（约 1 分钟）：第 9–20 针应读 **1k…12k kHz**、第 22 针应读 **13 kHz** |

> ⚠️ **重要更正**：旧表里标的"实测锚点：**9 = `pwm_l`、11 = `pwm_h`**"是**跟着 10/10 那次读图错误来的**，**不是物理实测** —— 已在上面表格里删掉。**真正物理确认过的只有 `IO1_1N`=3 / `IO1_1P`=4。**
> 📌 待 数字控制侧发来**最终确认**后，可将本列整体标注为"**已物理实测确认**"。
> 💡 **第 1 针 = `GND`** —— 数字控制侧已采纳 硬件侧的建议：**示波器地夹直接夹第 1 针**（位置最好找），不用满排针找地 ✅

**⭐ 算术交叉验证（硬件侧补）**：J10 是 **2×20 = 40 针**。按新表：
`IO1_1`~`IO1_17` 共 **17 对 = 34 针**（占第 **3–36** 针）＋ **6 针电源/地**（1=GND、2=`VCC5V`、37/38=GND、39/40=`VCC3V3`）= **40 针** ✅ **分毫不差** —— 这是新表最有力的旁证。
（旧表按"前 7 对全在左列"读，**根本装不满 40 针**，本身就不自洽。）

| J10 针 | 网络名 | 我们的信号 | 针 | 网络名 | 我们的信号 |
|---|---|---|---|---|---|
| **1** | **`GND`** | — | **2** | `VCC5V` | ⛔ **不接** |
| **3** | `EX_IO1_1N` | `pwm_l`（W19） | **4** | `EX_IO1_1P` | `pwm_h`（W18） |
| **5** | `EX_IO1_2N` | `FAULT_N`（R14） | **6** | `EX_IO1_2P` | `SD`（P14） |
| **7** | `EX_IO1_3N` | `pwm_tick`（Y17） | **8** | `EX_IO1_3P` | `ADC_CLK`（Y16） |
| **9 / 10** | `EX_IO1_4N/P` | `ADC_D0` / `D1` | **11 / 12** | `EX_IO1_5N/P` | `ADC_D2` / `D3` |
| **13 / 14** | `EX_IO1_6N/P` | `ADC_D4` / `D5` | **15 / 16** | `EX_IO1_7N/P` | `ADC_D6` / `D7` |
| **17 / 18** | `EX_IO1_8N/P` | `ADC_D8` / `D9` | **19 / 20** | `EX_IO1_9N/P` | `ADC_D10` / `D11` |
| **21** | `EX_IO1_10N` | 备用（V18） | **22** | `EX_IO1_10P` | **`OTR`**（V17） |
| **23–36** | `IO1_11`…`IO1_17` 的 N/P | **备用池**（14 个 IO） | **37 / 38** | `GND` | 接线前用万用表确认 |
| **39 / 40** | `VCC3V3` | 我们取 **3V3**（39 或 40） | | | |

### 信号 — 针号对应表

| 信号 | 旧（错） | **新（对）** | | 信号 | 旧（错） | **新（对）** |
|---|---|---|---|---|---|---|
| `pwm_h` | 11 | **4** | | `ADC_D4` / `D5` | 17 / 19 | **13 / 14** |
| `pwm_l` | 9 | **3** | | `ADC_D6` / `D7` | 13 / 15 | **15 / 16** |
| `SD` | 7 | **6** | | `ADC_D8` / `D9` | 32 / 33 | **17 / 18** |
| `FAULT_N` | 5 | **5**（巧合没变） | | `ADC_D10` / `D11` | 30 / 31 | **19 / 20** |
| `ADC_CLK` | 3 | **8** | | `OTR` | 29 | **22** |
| `pwm_tick` | 1 | **7** | | 备用 `IO1_10N` | 28 | **21** |
| `ADC_D0` / `D1` | 25 / 27 | **9 / 10** | | `VCC5V` | 2 | **2**（不变） |
| `ADC_D2` / `D3` | 21 / 23 | **11 / 12** | | `VCC3V3` | 39/40 | **39/40**（不变） |
| | | | | `GND` | 36–38 | **1 / 37 / 38** |

> 📌 **好消息**：**FPGA 球号不变**（硬件侧复核的 20/20 依然成立）→ **XDC / RTL 一行都不用动**；
> **H 区 `J3` / I 区 `J4` 的板级设计也不用改** —— 我们用"自有功能序 + 单根杜邦线"，**针号只在接线那一刻才对上** ✅

## 二·补4、I 区（AD9226 模块接口）—— 详见《I区排布与接线要点-20261010.md》

| 排针 | 脚 | 信号 | 方向 | 说明 |
|---|---|---|---|---|
| **`J4`**（2×13 = 26P） | 1–12 | `ADC_D0`–`ADC_D11` | 入 | ← H 区 `J3.7`–`J3.18`（**`D0`=LSB**） |
| | 13 | `OTR` | 入 | ← `J3.19` = `IO1_10P`(V17) |
| | 14 | `ADC_CLK` | **出** | ← `J3.5` = `IO1_3P`(Y16)，**2 MHz** |
| | 15 / 18 | `GND` | — | 板 `GND` |
| | 16 | `5V` | 出→模块 | 板 `5V`（＋`C33` 10 µF / `C34` 100 nF 去耦） |
| | 17 | `3V3` | — | 备用（模块不需要就悬空） |
| | 19–26 | `NC` | — | 备用（以后 DAC 用，**H 区 `J3.23–26` 也留了 4 针**） |
| **`J5`**（2P） | 1 / 2 | `VSENSE` / `GND` | 入 | ← E 区（0–2 V） |
| **`J6`**（2P） | 1 / 2 | `ISENSE` / `GND` | 入 | ← F 区 INA180A2 输出（0–2 V） |

### AD9226 验收条件第 ⑥ 条（最重要）

> **`DRVDD` 必须接 3 V / 3.3 V —— 数字输出高电平必须 ≤ 3.3 V。**

**依据**（ADI 原厂手册 AD9226 Rev. B 原文）：
> `FEATURES：Single 5 V Analog Supply, 3 V/5 V Driver Supply`
> `PRODUCT DESCRIPTION：It also features a separate digital output driver supply line to accommodate 3 V and 5 V logic families.`
> `规格表标准条件：(AVDD = 5 V, DRVDD = 3 V, fSAMPLE = 65 MSPS …)`

| 模块 `DRVDD` | `D0–D11`/`OTR` 高电平 | 后果 |
|---|---|---|
| **3 V / 3.3 V** ✅ | ≈3 V | 可**直连** FPGA（LVCMOS33） |
| **5 V** ❌ | ≈4.5–5 V | 🔴 **直接灌进 XC7Z020 的 IO → 打坏 FPGA 引脚** |

**上电第一次务必先用示波器量 `D0` 的高电平，确认 ≤3.3 V 再接 FPGA** —— 这条会烧板子。

> **数字控制侧补充的量化依据（2026-10-10 深夜）**：**7 系列 IO 的绝对最大输入 ≈ `VCCO + 0.55 V = 3.85 V`**（我们 bank 34 是 3.3 V、`ADC_D`/`OTR` 是 **LVCMOS33 输入且无内部钳位**）→ **5 V 必然损坏**，结论成立 ✅
> 数字控制侧已把它落成 `06-上板调试/AD9226上电前安全检查.md`（到货后**接 FPGA 之前**按 6 步做：先单独给模块上电 → 量 `D0` 高电平 ≤3.3 V → 再接）；兜底方案：**优先改模块 `DRVDD` 到 3 V；否则加 74HCT245 电平转换；绝不直连**。ADC 接口代码里 `ADC_D[11:0]`/`OTR` 一律 **LVCMOS33** 约束 ✅

### AD9226 全部 6 条验收（汇总）

| # | 要求 | 为什么 |
|---|---|---|
| ① | **输入直流耦合** | 要测 `VOUT` 的**直流电平**；AC 耦合则电压环作废 |
| ② | 12 位数据**并行**输出 | 与冻结的 `ADC_D[11:0]` 一致 |
| ③ | **`OTR` 引出** | 超量程标志 |
| ④ | **采样时钟可切外部输入**（板载晶振能断开/跳线） | 2 MHz 必须由 FPGA 给（架构卖点） |
| ⑤ | 输入量程 **0–2 V**（或 2 Vpp）+ 高阻缓冲 | E 区按 2.00 V 满量程设计；**实测该模块输入为 50 Ω 端接** ⇒ 10/24 联调改用**外部低阻分压（220 Ω / 2.2 kΩ，比值 0.2017）**临时接入，下一版 PCB 加跟随器 ✅ |
| ⑥ | 🔴 **`DRVDD` 接 3 V/3.3 V，数字输出 ≤3.3 V** | **否则打坏 FPGA 的 IO** |

> 📌 **I 区不串阻尼电阻**（2 MHz + 3 V 摆幅，风险可控）。若调试时数据位错乱，**先把 `ADC_CLK` 降频**（500 kHz / 100 kHz，免费且最有效）→ 再缩短杜邦线 → 最后才考虑改板加 22 Ω。

## 三、采样通道（电压 / 电流 / ADC）

| 信号 | 路径 | 方向 | 电平 | FPGA 引脚 | 端子 | 备注 |
|---|---|---|---|---|---|---|
| **输出电压 `VSENSE`** | Vout 分压 **→ 运放缓冲（单位增益）** → RC 滤波 → ADC 输入 | — | **工作点 0.39：VOUT=5 V 时 1.95 V**；模块 ±5 V↔全量程（**实测 416 码/V、零点 2048**）⇒ 饱和点 **12.6 V** ✅ | — | VSENSE | **分压 30k : (10k + 10k 电位器) = 0.25–0.40 可调，工作点 0.39**；⚠️ **分压器戴维南阻抗 12 kΩ，模块输入为 50 Ω 端接 ⇒ 必须加单位增益运放缓冲**（RRIO/单电源 5 V/失调≤数百µV/输出≥50 mA），否则 VSENSE 被吊载到不足 2%（仅约 3 个码）；`R7/R8/R9/RP1/C30/D5/TP1`，见《E 区排布与接线要点-20261010.md》§四·补。**实测证实**：直接相连时 VSENSE 由 1.70 V 跌到 0.047 V，故联调阶段改用外部低阻分压 0.2017 ✅ |
| **采样电流 `ISENSE`** | 10 mΩ → INA180A2（G=50）→ ADC 输入 ／ LM393 | — | 0 ~ 2 V | — | ISENSE | 4 A → 40 mV → 2 V |
| ADC 数据 | AD9226 `D[11:0]` → FPGA | in | 3.3 V | 【待定】×12 | — | **12 位全并行** |
| ADC 过压指示 | AD9226 `OTR` → FPGA | in | 3.3 V | 【待定】 | — | 量程溢出指示，当"输入超量程"标志用 |
| ADC 时钟 | **FPGA → AD9226 `CLK`** | out | 3.3 V | **Y16**（板级网名 `IO1_3P`） | ACLK | **2 MHz**（200 MHz ÷ 100），50% 占空比 |

**为什么 ADC 时钟必须由 FPGA 给**（硬件侧 2026-10-08）：
"PWM 同步采样 / 安静窗取数"是本作品的架构卖点，ADC 若用自带晶振自由运行，等于放弃这条。
FPGA 的 2 MHz 分频与 DPWM 的 `count` **同源**，所以相位固定——
以后取数点落在安静窗内只需要调一个常数偏移，可以精确算出来、也可以复现。

> **采样怎么同步**：AD9226 是流水线 ADC，一直在转换；"同步"靠的是 PL 内部**在固定相位锁存数据**，
> 不是外部触发线。`period_tick` 用于这件事，**不引出到板子上**。
> 【待定】AD9226 模块若自带晶振，到手要看模块原理图确认能否旁路。

## 四、供电与地

| 项 | 路径 | 电平 | 端子 | 备注 |
|---|---|---|---|---|
| 功率输入 | 适配器 → 功率级 | 24 V，**必须限流：2 A 起步（首次上电 0.5 A）** | 24V | **⛔ 2026-10-09：硬件侧决定不装保险丝**（嫌换管麻烦）→ **限流电源成为唯一的第一道防线**；报告口径相应改为"两道防线"（限流电源 + 逐周期 OCP/驱动关断）。若日后想补，PTC 自恢复保险丝最省事 |
| 辅助电源 | 适配器 → LM2596① → 12 V → LM2596② → 5 V | 12 V → 5 V | 12V / 5V | ✅ **12 V 保留（10/8 硬件侧答复）**：IR2110 VCC 需 10–20 V，24 V 直供超上限、5 V 不够，此路刚性 |
| 驱动电源 12 V | LM2596① → **IR2110 `VCC`**（门驱动）＋ 自举二极管 UF4007 充电 | 12 V | 12V | IR2110 门驱动电源需 10–20 V；**与逻辑电源分开走线**，就近去耦 10µF+100nF（10/9 硬件侧补：原表把这一路漏写了） |
| 逻辑电源 5 V | LM2596② → **IR2110 `VDD`** / 74HCT245 / LM393 / INA180A2 | 5 V | 5V | **不要从 FPGA 板上偷电**；每个 IC 就近 100nF |
| 地（关键） | 功率地（A 区电容负极·C 区下管源极·采样电阻）与控制地（LM2596·IR2110 VSS·245·LM393·INA180）**分开走** | 0 V | GND | **只在一个点（总星点）汇合**；两条地之间不许有第二条通路——否则 LM2596 的 150 kHz 地电流灌进采样电阻，导致 OCP 误触发 / ADC 读数跳（10/9 硬件侧，详见《B 区排布与接线要点》） |
| 3V3 参考 | 核心板 → 功率板 | 3.3 V | 3V3 | **仅限小信号，< 100 mA**（硬件侧 H 区预算写明） |
| FPGA 板供电 | 核心板自己的 **+5 V / 2 A** 适配器（**10/9 数字控制侧更正：不是 12 V**） | 5 V | — | 与功率级**只共地，不共 5 V**；⚠️ 扩展口上若有 5 V 针，**功率板侧一律不接**（防止两路 5 V 被并到一起） |

**红线**：24 V（更别说市电）**永远不直接接触 FPGA 引脚**；中间必须有驱动器 / 分压 / 隔离。

## 五、不是接线、别引出的信号

| 信号 | 说明 |
|---|---|
| `clk`（200 MHz） | PL 内 Clocking Wizard 从板载 50 MHz 倍频得到，不出板 |
| `period_tick`（内部） | PL 内部使用（锁 ADC 采样时刻、控制环节拍）；**作为内部信号不引出** |
| `pwm_tick`（v1.1 新增，可选） | ✅ **引出到 `Y17`**（板级网名 `IO1_3N`）—— 示波器测试点，10/14 量死区正需要；不接也能跑 |
| `rst_n` | ✅ **核心板板载按键**（bring-up 不依赖 PS）；XDC 里映射 + 消抖/同步。PS 软复位以后走 AXI 寄存器内部实现，**不占 H 区针** |

## 六、H 区针数预算（按 2×13 = 26P 排针预留）

| 用途 | 方向（相对 FPGA） | 针数 |
|---|---|---|
| `PWM_H` / `PWM_L` / `SD` | 发 | 3 |
| `FAULT_N` | 收 | 1 |
| `ADC_D[11:0]` + `OTR` | 收 | 13 |
| `ADC_CLK` | 发 | 1 |
| `3V3`（核心板 → 功率板，仅小信号 < 100 mA） | 收 | 1 |
| `GND` | — | 2–3 |
| **合计** | | **21–22 / 26**（余量 4–5 针） |

## 七、变更记录

| 日期 | 谁 | 改了什么 | 为什么 |
|---|---|---|---|
| 2026-10-07 | 工作区会话（数字控制侧侧） | 建 v0.1 草案 | 10/6 起欠账；硬件侧画原理图与 10/9 bring-up 都要用它 |
| 2026-10-07 晚 | 数字控制侧 | `fault_i` 极性定为 Verilog 顶层取反；板卡确定为正点原子领航者 ZYNQ-7020 | 用户决定 |
| 2026-10-08 | 数字控制侧侧 | 网名 `ocp_n` → `FAULT_N`；新增与分区模板 H 区的对照；发现 `SD_EN` 是新接口 | 与 B 的原理图对齐 |
| **2026-10-08** | **硬件侧评审** | ① 网名 `SD_EN` → **`SD`**，真值表写死 0=正常/1=关断；② 增加 **2FF 同步器**；③ **两级保护**：DPWM 用原始故障、`SD` 用闩锁；④ D 区 245 A 侧加 **3×10 kΩ 下拉**（BOM #24）；⑤ **ADC_CLK 由 FPGA 出，2 MHz**；⑥ ADC **12 位全并行 + OTR**；⑦ **`rst_n` 用核心板按键**，PS 软复位走 AXI 不占针；⑧ 给出 **H 区 26P 针数预算** | 硬件侧评审 |
| 2026-10-08 | 数字控制侧侧 | 本表升级 v0.2；更正"上拉电阻会拖慢保护"的说法（快沿在比较器拉低那一侧，10 kΩ 不影响保护响应） | 记录更正，避免口径错误 |
| 2026-10-08 晚 | **硬件侧** | **批准冻结 v1.0**；板卡锁定黑金 ALINX AX7020（引脚资料源→ALINX 官网手册）；#5 12V 保留、#10 清单位置闭环（#3 分压比仍待 ADC 量程） | 板卡下单；交接单四问答复 |
| 2026-10-09 晚 | **硬件侧** | 第四节供电表**拆分并补漏**：新增「驱动电源 12 V → IR2110 `VCC`」一行（原表只写了 5 V，VCC 那一路漏了）、新增「地：功率地/控制地分走 + 单点汇合」一行；其余不动 | 画 B 区（辅助电源）时发现；**待 数字控制侧点头**（涉及 IR2110 供电契约） |
| 2026-10-09 晚 | **硬件侧** | 新增「二·补2 跨区网络名清单」（冻结）：统一 `24V_BUS`/`12V`/`5V`/`3V3`/`GND`/`PWM_H`/`PWM_L`/`SD`/`FAULT_N`/`ADC_*`，禁止跨区自创别名 | A 区原理图把 24V 母线写成 `VCC`、B 区也写成 `VCC`——重名风险，需全区统一 |
| **2026-10-10** | **硬件侧** | 升 **v1.1**：① 填 6 个引脚号（数字控制侧 10/9 交接单）② 板卡供电 **12 V → +5 V/2 A**、补 `XC7Z020-2CLG400I`（Vivado `xc7z020clg400-2`）与 80 针扩展口 ③ `SD` 的 10 kΩ **下拉 → 上拉到 `3V3`**（硬件侧 10/09 提案，**待 数字控制侧点头**）④ `pwm_tick` 由"不引出"改为**引出 `Y17`（可选）** ⑤ 新增「二·补3 H 区引脚表」并登记 **`ADC_D[11:0]`+`OTR` 13 根待补** | 收到 数字控制侧《给 硬件侧 · 交接单（10/09 晚）》；同时更正本表 §四「板载 12 V 适配器」的**错误**（数字控制侧实测为 +5 V/2 A） |
