ShibainuQAQ/FPGA/04-技术文档/README.md

# 技术文档文件夹说明

> 面向 **2026 嵌入式芯片与系统设计竞赛（AMD 赛道）** 技术文档提交
> 按《技术文档模板.docx》的五部分结构编写，**不含任何学校/个人信息** ✅

---

## 一、文件清单

| 文件 | 说明 |
|---|---|
| **`技术文档-FPGA数字电源-20261012.docx`** | ⭐ **主交付物** —— 按模板结构编写的技术文档（五部分：作品概述 / 系统组成及功能说明 / 完成情况及性能参数 / 总结 / 参考文献）|
| `工具/生成脚本.py` | 文档与插图的生成脚本（python-docx + Pillow），**改文字/改图后重跑即可再生成** |
| `工具/校验.py` | 自动校验：页眉图片、页脚页码、版心、表格/插图宽度、章节齐备 |
| `图/图1-1-设计流程.png` | 图 1-1（脚本生成）|
| `图/图2-1-系统整体框图.png` | 图 2-1（脚本生成）|
| `图/图2-2-九区划分与信号流.png` | 图 2-2（脚本生成，板级布局俯视图）|
| `图/待插入图清单.md` | ⭐ **需要你自己补的截图/照片清单**（文档里已用红字占位）|
| `checks.json` | 结构检查结果（`verdict: pass`）|

> ⭐ **本文档以《技术文档模板.docx》为底稿生成** —— **页眉图片（“芯辰大海 点亮未来” Logo）**、**页脚页码域（`PAGE`）**、全部样式与页面设置**原样继承** ✅
> 校验结果：页眉图片 **2.565″ × 0.469″**、页脚含 `PAGE` 域、A4、版心 **5.768″** ✅

---

## 二、排版参数（与模板一致）

| 项 | 值 |
|---|---|
| 页面 | A4（8.27″ × 11.69″）|
| 页边距 | 左右 1.25″（3.18cm）／上下 1″（2.54cm）|
| 版心宽 | **5.768″** |
| 正文 | 宋体 + Times New Roman，12 pt，行距 1.35 |
| 标题 | 作品名 18 pt / 部分标题 14 pt / 小节标题 12 pt（黑体加粗）|
| 表格 | 三线外框（Table Grid），10–10.5 pt，**总宽 5.70″** ✅ 不超版心 |
| 插图 | 居中，**宽 5.60″** ✅ 不超版心 |

> ✅ 已用脚本核算：**3 张表格 + 4 处插图全部 ≤ 版心宽**（此前设成 6.0–6.4″ 会溢出，已修正）。

---

## 三、⭐ 怎么继续补图（3 步，**不用改脚本**）

> 生成器是**清单驱动**的：**有图就插、没图就自动留红字占位**。

```
第 1 步  把图片文件放进 图/ 目录
         （文件名不用一字不差：脚本会忽略空格、不区分大小写；
           具体候选名见 图/待插入图清单.md 的「期望文件名」列）
第 2 步  重跑生成器（见下方命令）
第 3 步  打开 docx 检查；清单文件 图/待插入图清单.md 会自动更新状态 ✅
```

**当前进度：已插入 16 张 / 待补 9 张**

| 已插入 ✅ | 待补 ⏳（把文件放进 `图/` 后重跑即可）|
|---|---|
| 图 1-1、2-1、2-2（脚本生成）<br>图 2-3 功率板 PCB 版图<br>图 2-5 ~ 2-13 九个区原理图<br>图 3-4 整机原理图总览（a）（b）<br>图 3-5 PCB 布线与地平面 | **图 2-4** 整机装配与散热<br>**图 2-14** RTL 顶层框图<br>**图 3-1 / 3-2** 实物正面 / 45°<br>**图 3-3** PCB 3D 或实物<br>**图 3-6** DPWM 波形与死区<br>**图 3-7** 保护响应波形<br>**图 3-8** ILA 截图<br>**图 3-9** 输出纹波与阶跃 |

> 📌 **文件名建议**（放进去就能自动认）：
> `整机装配与散热.png`、`RTL顶层框图.png`、`实物正面.png`、`实物45度.png`、`PCB3D预览.png`、
> `DPWM波形.png`、`保护响应.png`、`ILA截图.png`、`输出纹波.png`
> （上表列出的**其他候选名也认**，见 `图/待插入图清单.md`）

### 实测数据（第三部分表 3-1）

表 3-1 中 **8–12 号**目前是"待测"，板子到货联调后填入：

| 序号 | 指标 | 状态 |
|---|---|---|
| 8 | 输出电压 | 待联调 |
| 9 | 输出纹波 | 待联调 |
| 10 | 负载调整率与跳变恢复 | 待联调 |
| 11 | 效率 | 待联调 |
| 12 | 过流保护点 | 待联调 |

### 需要最终核对的表述

- **`DPWM 分辨率`** 统一写 **5 ns（占空比步进 0.1%）** —— 这是实现与实测口径，不再出现"亚 ns/等效 13 bit"。
- **`效率`／`纹波`** 等未实测指标**不要预先填猜测值** ✅

---

## 四、如何修改与重新生成

```powershell
cd '04-技术文档'
# ① 只改文字 → 直接用 Word/WPS 打开 docx 编辑（最省事）
# ② 补图 / 批量改内容 → 放好图后重跑生成器：
& 'C:\Users\22431\.dsh\dsh-runtimes\dsh-primary-runtime\dependencies\python\python.exe' '生成脚本.py'
# ③ 校验（页眉图片 / 页脚页码 / 版心 / 表格与插图宽度 / 章节齐备）：
& 'C:\Users\22431\.dsh\dsh-runtimes\dsh-primary-runtime\dependencies\python\python.exe' '校验.py'
```

> ⚠️ **重跑 `工具/生成脚本.py` 会覆盖 `技术文档-FPGA数字电源-20261012.docx`。**
> 所以：**已经用 Word 手工改过的文字/数据，重跑前先另存备份**（或把改动同步回脚本）✅
> **补图不受影响** —— 图片只要在 `图/` 目录里，重跑一定会被插入 ✅

---

## 五、文档结构总览（与模板对应）

| 模板要求 | 本文档 | 字数控制 |
|---|---|---|
| 作品名称 | 基于 FPGA 的全数字控制同步 Buck 降压电源设计 | ✅ |
| 摘要 | 摘要（约 750 字）| ✅ 800 字内 |
| 一、作品概述 | 1.1 功能与特性 / 1.2 应用领域 / 1.3 主要技术特点 / 1.4 主要性能指标（表）/ 1.5 主要创新点 / 1.6 设计流程（图）| ✅ 各节 400/400/400/200/200/200 字内 |
| 二、系统组成及功能说明 | 2.1 整体介绍（图 2-1）／2.2 硬件系统（2.2.1 整体+图 2-2+表 2-1 / 2.2.2 机械 / 2.2.3 电路九区）／2.3 软件系统（2.3.1 整体 / 2.3.2 五个模块）| ✅ |
| 三、完成情况及性能参数 | 3.1 整体 / 3.2 工程成果（机械/电路/软件）/ 3.3 特性成果（表 3-1）| ✅ |
| 四、总结 | 4.1 可扩展之处 / 4.2 心得体会 | ✅ 300/1000 字内 |
| 五、参考文献 | 12 篇（≤20）| ✅ |

---

## 六、口径纪律（写文档时一直遵守的）

| 规则 | 说明 |
|---|---|
| **只写已实测的数字** | DPWM 200.00 kHz、980/3980 ns、**死区 200.0 ns（40 × 5 ns）**、**保护数字链路 58 ns／含 1 µs 滤波端到端 ≈1.0 µs**、ADC 自检 7/7 —— 均来自实测/仿真 ✅ |
| **未测的一律标"待测"** | 效率、纹波、负载调整率等**不预填猜测值** ✅ |
| **不写未核实的型号/手册原文** | 参考文献只列实际查阅过的数据手册与标准 ✅ |
| **不出现学校名称等信息** | ✅ |
| **口径谨慎** | 只写已实测的 **5 ns** 分辨率；不写未验证的分辨率数字 ✅ |
