ShibainuQAQ/FPGA/03-EDA导出/网表与BOM核对-20261010.md

# 网表 + BOM 核对 · 2026-10-10（用户新导出版）

> **源文件**：`Netlist_DC-DC电源_2026-10-10.tel`（65 行，00:29 导出）、`BOM_Board1_DC-DC电源_2026-10-10.xlsx`（29 行数据 + 表头，00:28 导出）
> **方法**：逐网络、逐引脚读网表原文 + 逐行读 BOM 单元格（openpyxl，非截图）——**不猜像素**

---

## 一、结论（三句话）

1. **连线（网表）全对，一个字都不用改** —— A/B/C 三区与 10/09 版**逐字相同**，10/09 已通过的结论继续成立（`24V`/`12V`/`5V`/`VOUT`/`SW`/`HO`/`LO`/`ISENSE_P` 全部正确）。
2. **BOM 里只有 1 行是真错**：`No.5 = C11,C15,C16` —— 封装被改成 `C0805` 后，选中的件变成了 **0805 的 10µF/25V 陶瓷**，而 **C11 就挂在 24V 母线上**。这条**必须改**（详见第三节）。
3. **现在这块图还不能打板**：`U3/U4/D4`（栅极驱动）**仍未连任何线**，E/F/G 区未画 → 打出来的板子**没有栅极驱动，功率级根本不会开关**，且 PCB 只有一次容错。

---

## 二、网表逐网络核对（第 44–63 行）

| 网络 | 网表成员 | 判定 |
|---|---|---|
| `24V` | C1.1 C2.1 C3.2 C4.2 **C11.2** C23.2 D1.2 LED1.2 Q1.2 U1.1 | ✅ 与 10/09 版一致 |
| `12V` | C5.2 C6.2 C9.2 C12.2 C14.2 L1.2 LED2.2 **U1.4(FB)** **U2.1(VIN)** | ✅ 级联正确，**无二极管** |
| `5V` | C7.2 C8.2 C10.2 C13.2 L2.2 LED3.2 U2.4(FB) | ✅ 与 `VOUT` 未混网 |
| `VOUT` | C15.2 C16.2 C17.2 C18.2 C19.2 C20.2 L3.2 | ✅ 独立 |
| `SW` | L3.1 Q1.3 Q2.2 R_gs1.1 | ✅ 半桥中点 |
| `ISENSE_P` | Q2.3 R_gs2.1 R_shunt.2 | ✅ 开尔文点取自 R_shunt 上端 |
| `GND` | 39 个引脚（J1.2 / R_shunt.1 / U1·U2 的 3·5·6 / 续流管阳极 / 全部电容地 …） | ✅ |
| U1 开关节点 `$1N17` | **D2.1** L1.1 U1.2 | ✅ 续流管阴极朝开关节点 |
| U2 开关节点 `$1N58` | **D3.1** L2.1 U2.2 | ✅ 同上 |
| `HO` / `LO` | R_g1.2 / R_g2.2 | ⚠️ 只到栅极电阻 —— **U3 还没接进来（未接线，不是接错）** |
| A 区 | `$1N1` J1.1 SW1.1 ；`$1N20` D1.1 SW1.2 | ✅ |
| 指示灯 | `$1N7`/`$1N19`/`$1N32` = LED1/2/3.1 + R1/2/3.2 | ✅ |

> **`U3`(DIP-14)、`U4`(TSSOP-20)、`D4`(DO-41) 在 `$NETS` 里一次都没出现** —— 元件已摆上、封装已在 `$PACKAGES`（第 18/20/40 行），但**一根线都没连**。
> 另外 `ISENSE_N` **仍未单独建网**（`R_shunt.1` 直接在 `GND` 网里）—— 网表上可接受，但**实装时这根线必须从 R_shunt 焊盘根部单独引**（开尔文），不能共用 GND。

---

## 三、BOM 逐行（29 行）

### ✅ 已选料且封装正确（14 行，可直接下单）

| No. | 位号 | 型号 | 立创编号 | 封装 |
|---|---|---|---|---|
| 1 | C1,C2 | JVJ50V100M6x8 | C46550415 | ⚠️ `CAP-SMD_…`（贴片名，实物是直插 6×8） |
| 2 | C3,C4 | 1210B106K500NT（10µF/**50V** X7R） | C116808 | `C1210` ✅ |
| 3 | C5–C8 | 178MU0002（100nF） | C5632426 | `CAP-TH_L5.8-W3.6-P5.0` ✅ |
| 10 | D1 | SS54 | C7420369 | `SMA`（贴片；买直插要改） |
| 11 | D2,D3 | 1N5825 | C3758179 | 直插轴向 ✅ |
| 12 | D4 | UF4007 | C960666 | `DO-41` ✅ |
| 13 | J1 | LAIL-PTB5.08-2P | C55145024 | 直插 ✅ |
| 17 | LED1–3 | XL-502SURD | C2895492 | 直插 ✅ |
| 18 | Q1,Q2 | IRLZ44N(UMW) | C42370423 | `TO-220-3` ✅ |
| 23 | R_shunt | FMF25FPJR010-LH | C105366 | `R2512` ✅ |
| 24 | SW1 | — | C2883961 | 直插排针 ✅ |
| 25 | U1 | LM2596HC5-12 | C55111448 | `TO-263-5`（贴片） |
| 26 | U2 | LM2596SX-5.0/NOPB | C10002 | `TO-263-5`（贴片） |
| 27 | U3 | IR2110PBF | C2967 | `DIP-14` ✅ |
| 28 | U4 | 74HCT245PW,118 | C5980 | `TSSOP-20`（贴片） |

### ❌ 唯一真错：No.5（C11, C15, C16）

| 列 | 内容 |
|---|---|
| Comment / Value | `470uF` |
| **Footprint** | **`C0805`**（0805 贴片） |
| **Manufacturer Part** | **`HGC0805R5106K250NSLJ`**（Chinocera 华瓷） |
| **Supplier Part** | **（空）** |

**问题：**

1. **0805 物理上装不下 470µF** —— 0805 MLCC 的上限也就几十 µF，而且要 6.3V 低压档次；
2. 料号按通用规则解码：`HGC`(华瓷) + `0805`(尺寸) + `R5`(介质) + **`106`(=10µF)** + `K`(±10%) + **`250`(=25V)** + `NSLJ`。同表 No.2 的 `1210B106K500NT` 用的是同一套规则（`B`=X7R、`106`=10µF、`500`=50V），可互证 → **这颗是 10µF / 25V**。
   （说明：本次**外网搜索仍被限流**（Firecrawl 429，retry_after ≈ 58057 s ≈ 16 h），**未能在立创商城页面逐字复核该料号**，以上是**料号规则解码 + 封装上限**两条独立证据，不是页面原文。）
3. **`C11` 挂在 `24V` 母线上**（网表第 55 行）。**25V 耐压用在 24V 上 = 没有裕量**（常规要求 ≥1.5–2×），加上 MLCC 的直流偏压衰减，属于**上电随时可能裂/击穿短路**的器件 —— **必须改**。
4. `C15/C16` 挂在 `VOUT`(5V)：**耐压够（25V 对 5V = 5× 裕量）→ 这两颗的"件"本身没错，不需要换**。但图上值写 `470µF`、实际件是 10µF，**文字对不上**，必须把值改成实际值，否则以后（打板／采购／报告）有人照 `470µF` 去买，会买回一颗塞不进 0805 的电解。
   **容量够不够？两条都算过 —— 够：**
   - **稳态纹波**：`VOUT` 上还有 C17–C20（22µF×4 ≈ 88µF），加 C15/C16 共 ≈**108µF 陶瓷**；`ΔV ≈ ΔI/(8fC)` = 1.98A/(8×200k×108µF) ≈ **12mV** ✅（陶瓷 ESR 比电解小两个数量级，稳态纹波只会更小）
   - **负载跳变（0→3A）**：这里不是靠电容硬扛，而是靠**电感电流爬升**：`di/dt = (Vin−Vout)/L` = 19V/10µH = **1.9A/µs** → 1.6µs 就补上 3A；电容只需补 `½·ΔI·t` = 2.4µC → 压降 = 2.4µC/108µF ≈ **22mV** ✅
   - ⚠️ **前提**：上面两个数都建立在 **C17–C20（4×22µF）必须装上** 之上（它们现在还是未选料 + `C0603` 占位）。**少了这 88µF**，108µF → 20µF，纹波变 ≈124mV、跳变压降变 ≈120mV —— 还是能跑，但差一个数量级。
5. 该行 **立创编号为空**，本来就没落地（也要手动挑）。

> **一句话分清**：**只有 `C11` 需要换"件"**；`C15/C16` 的件是好的，**要改的只是图上的值**（两个字）。

### ⬜ 未选料（12 行，本来就空）

`No.4` C9,C10 ｜ `No.6` C12 ｜ `No.7` C13,C14 ｜ `No.8` C17–C20 ｜ `No.9` C23 ｜ `No.14` L1 ｜ `No.15` L2 ｜ `No.16` L3 ｜ `No.19` R1,R2 ｜ `No.20` R3 ｜ `No.21` R_g1,R_g2 ｜ `No.22` R_gs1,R_gs2

---

## 四、"必须改" vs "可以不管"

| 项 | 判定 | 最少改法 |
|---|---|---|
| **C11 的选件（25V 装 24V）** | 🔴 **必须换件** | 改设计值为 `10µF/50V`、封装 `C1210`、选料复用 **C116808**（BOM 里已有，数量 2→3）——**不用买新件**。或保持 470µF/50V → 用 **C4930 / C88733** + 直插电解封装 |
| **C15/C16 的件** | 🟢 **不用换**（5V 上 25V 够、容量算够） | 不动 |
| **C15/C16 的值（图上写 470µF 与实际不符）** | 🟠 要改字 | 图上值改成 `10µF/25V`（封装/选料都不动）。**前提：C17–C20 的 88µF 要装上**，否则纹波/跳变差一个数量级 |
| **C17–C20（22µF×4）** | 🟠 要选料 | 未选料 + `C0603` 占位 → 选 **1206** 贴片 22µF/25V（`C1206`），**打板必须改** |
| **L1/L2/L3 的封装**（`L0805`/`L0603`） | 🔴 **打板则必须改** | `L0xxx` 是**贴片电感**封装，68µH/33µH/10µH(6A) **一颗都装不上** → 改直插电感封装（见《封装与实物对照表》六·补） |
| C12/C13/C14/C23 的 `C0603` | 🔴 **打板则必须改** | 0603 装不下 220–680µF；改直插电解（见《封装与实物对照表》§六） |
| R1–R3 / R_g / R_gs 的 `R0603` | 🟡 打板才需改 | 贴片 0805/1206 或直插金属膜；**手搭洞洞板不用管** |
| U4 `TSSOP-20`、U1/U2 `TO-263`、D1 `SMA` | 🟢 打板可焊 | 打板保持即可；**洞洞板手焊难**（U4 尤其） |
| C1/C2 `CAP-SMD_…` 封装名 | 🟢 不用管 | 实物是直插 6×8（已买 C46550415），**打板时改成直插电解封装**即可 |
| `ISENSE_N` 未单独建网 | 🟢 不用管 | 实装时从 R_shunt 焊盘根部**单独引线**（开尔文） |
| A 区 TP1–TP3 测点 | 🟢 可选 | 想量电压就加，不加也不影响 |

---

## 五、打板前提（三条，缺一不可）

1. **原理图画完**：A/B/C ✅ —— **D 区（U3/U4/D4）一根线没连** ❌、E/F/G 未画 ❌；
2. **全部封装对齐实物**：还差第三节两处 🔴（C11 + 全部电感/电解）；
3. **BOM 无空行**：还差 12 行未选料 ❌。

> **当前最缺的一块是 D 区**：没有 IR2110，`HO`/`LO` 只是两根断在栅极电阻上的线 —— **打出来的板子功率级不会开关**。PCB 一次容错，**建议等 D/E/F/G 画完再一次性打板**；等板期间按原计划用洞洞板搭"最小功率级"（IR2110 + 2×IRLZ44N）验证自举与死区。

---

## 六、封装统一：贴片陶瓷**只用 `C1206`**（2026-10-10 用户口径）

> 用户口径：**贴片件只有 `C1206`**。结论：**可以，全部走 1206 没问题** —— 我们要的两档容值 1206 都有现货规格。

| 需求规格 | 1206 有没有 | 用在哪 | 备注 |
|---|---|---|---|
| **10µF / 50V X7R** | ✅ 标准规格，主流现货 | **C11**（24V 母线） | **耐压必须是 50V 档**；24V 偏压下容值掉 40–60%（≈4–5µF），作为 U1 输入高频旁路够用（24V 上另有 C1/C2 100µF×2 + C23 220µF + C3/C4） |
| 10µF / 25V X5R·X7R | ✅ 常见 | C15、C16 | 5V 上 25V = 5× 裕量 |
| 22µF / 25V X5R | ✅ 有（1206 的容量上限附近，属常见规格） | C17–C20 | 5V 偏压下掉 ~30% → ≈15µF/颗 |

**改法（C11）**：值 `10µF/50V`、封装 **`C1206`**、选料 → 立创筛「贴片陶瓷 → 1206 → 10µF → **50V** → X7R → 现货」，**把立创编号填进 BOM**（该行原来编号是空的）。

**顺手可统一（可选，不是必须）**：
- `C17–C20` → `C1206` + 22µF/25V（替代原 `C1210` 方案）；
- `C9/C10`（10µF/25V 去耦）本来就是 `C1206` ✅；
- `C3/C4` 现在是 `C1210` + **C116808**（`1210B106K500NT`，1210 规格）：**要么保持不动，要么一起换成 1206 的 10µF/50V**（换的话 C3/C4 与 C11 合并成一行 ×5）。⚠️ **1210 的件塞不进 1206 焊盘**，反之亦然，**封装与实件必须一致**。

**别混的两条**：
1. **`C1/C2` 不是 1206**：它们是**直插电解 100µF/50V 6×8mm**（已买 **C46550415**）；
2. **`C1206` 只手上有 25V/16V 档的话，C11 仍然不能用** —— 24V 上必须是 **50V** 那颗，这条不能让。

---

## 七、2026-10-10 00:36 再导出版复核：🔴 **`24V` 与 `GND` 短路（致命，必须先修）**

### 证据（网表第 56–59 行，纯算术，不靠猜）

- **`GND` 网络整个消失了** —— 全表只剩 16 个网，没有 `GND`；
- 上一版 `24V` = **10 个脚**：`C1.1 C2.1 C3.2 C4.2 C11.2 C23.2 D1.2 LED1.2 Q1.2 U1.1`
- 上一版 `GND` = **34 个脚**：`C1.2 C2.2 C3.1 C4.1 C5.1 C6.1 C7.1 C8.1 C9.1 C10.1 C11.1 C12.1 C13.1 C14.1 C15.1 C16.1 C17.1 C18.1 C19.1 C20.1 C23.1 D2.2 D3.2 J1.2 R1.1 R2.1 R3.1 R_shunt.1 U1.3 U1.5 U1.6 U2.3 U2.5 U2.6`
- 本版 `24V` = **44 个脚**，逐字读下来正好是上面两串的并集 —— **10 + 34 = 44，一个不多一个不少**。

→ **两个网被完全合并了**：`24V` 里同时出现 `C1.1` 和 `C1.2`、`C11.1` 和 `C11.2`、`U1.1`(VIN) 和 `U1.3/5/6`(GND)……
**结论：24V 直接短到地，上电即短路的硬伤。**

### 怎么定位（两步，30 秒）

1. 在原理图里搜 `GND`（Ctrl+F）：
   - **一个都搜不到** → 是某个 `GND` 网络标签／接地符号被改成了 `24V`（改回来即可，一处搞定）；
   - **还能搜到** → 是**多连了一根线**：某处本该接地的点被接到了 24V 上。
2. 右侧「网络」面板点 `24V` → 若**地面上那一大片同时高亮**，即证实合并。
3. **最大嫌疑就在 `C11`**（本轮唯一动过的地方）：网表显示 **`C11.1` 和 `C11.2` 现在都在 `24V` 上** —— 也就是说 **C11 两只脚都接到 24V 了**（它原本有一只脚是地）。把那只地脚接回 `GND` 即可。

### 修完的验收标准（再导一次网表，应逐字对上）

| 网络 | 成员 |
|---|---|
| `24V` | `C1.1 C2.1 C3.2 C4.2 C11.2 C23.2 D1.2 LED1.2 Q1.2 U1.1`（**10 个**） |
| `GND` | 上面那串 **34 个**（`C1.2 C2.2 C3.1 C4.1` … `U2.3 U2.5 U2.6`，含 `C11.1`） |

### 本版其它变化（只两处，其余一字未动）

| 项 | 状态 |
|---|---|
| `C11` 从 C15/C16 里**拆成单独一行**（BOM No.5，数量 1）、封装 `C0805`→`C1206` | ✅ 拆分对了；但 **值仍写 `470µF`** —— **1206 装不下 470µF**，值要改成 `10µF/50V`（否则照 `470µF` 买件照样装不上） |
| `C15/C16`（BOM No.8，`C0805` + `HGC0805R5106K250NSLJ` = 0805 10µF/25V） | 🟠 件没换 ✅；但 **值仍写 `470uF`**，要改成 `10µF/25V` |
| `12V` `5V` `VOUT` `SW` `ISENSE_P` `$1N17` `$1N58` `HO` `LO` | ✅ **与上一版逐字相同，全部正确** |
| `L1/L2/L3` 封装、`C17–C20` 的 `C0603`、`U3/U4/D4` 未接线 | ⚪ 与上一版相同（打板才需处理） |

---

## 八、2026-10-10 12:56 再导出版复核：✅ **`24V`/`GND` 短路已修好**

### 验收：逐字对上第七节给出的清单

| 网络 | 本版成员 | 脚数 |
|---|---|---|
| `24V` | `C1.1 C2.1 C3.2 C4.2 C11.2 C23.2 D1.2 LED1.2 Q1.2 U1.1` | **10** ✅（要求 10） |
| `GND` | `C1.2 C2.2 C3.1 C4.1 C5.1 C6.1 C7.1 C8.1 C9.1 C10.1 C11.1 C12.1 C13.1 C14.1 C15.1 C16.1 C17.1 C18.1 C19.1 C20.1 C23.1 D2.2 D3.2 J1.2 R1.1 R2.1 R3.1 R_shunt.1 U1.3 U1.5 U1.6 U2.3 U2.5 U2.6` | **34** ✅（要求 34） |

→ **两个网完全分开，`24V` 不再短到地**。全表 **18 个网**（比 00:36 版多回一个 `GND`）。

**其余网络与 00:36 版逐字相同、全部正确** ✅：`12V` / `5V` / `VOUT` / `SW` / `ISENSE_P` / `$1N1` / `$1N7` / `$1N17` / `$1N19` / `$1N20` / `$1N32` / `$1N38` / `$1N44` / `$1N58` / `HO` / `LO`。

### 仍未改的（都是"值／封装"级，不是新错；BOM 与 00:36 版逐行相同）

| 项 | 现状 | 要改成 |
|---|---|---|
| **C11** | BOM `No.5`：值 `470µF` + 封装 `C1206` + **Manufacturer Part 空** | 值 → `10µF/50V`；选料 → 立创筛「贴片陶瓷 / **1206** / 10µF / **50V** / X7R / 现货」 |
| **C15/C16** | BOM `No.8`：值 `470uF`，实件是 0805 10µF/25V | 值 → `10µF/25V`（**件与封装都不动**） |
| L1/L2/L3 | `L0805`(=L1) / `L0603`(=L2,L3) 仍是**贴片电感**封装 | **打板才必须改**（直插工字 Ø8–10／脚距 5.0／孔径 0.6，见《封装与实物对照表》六·补） |
| C17–C20 | `No.9`：`C0603` 占位、未选料 | 打板必须改；建议 **1206 + 22µF/25V** —— ⚠️ **这 88µF 直接关系 `VOUT` 纹波与跳变**（少了它 108µF→20µF，差一个数量级） |
| C12/C13/C14/C23 | `C0603` 占位 | 打板必须改直插电解 |
| R1–R3 / R_g / R_gs | `R0603` | 打板才需改 |
| **U3/U4/D4** | `$NETS` 里**仍未出现** | **D 区仍未接线** → 没有栅极驱动，**仍不能打板** |
| E/F/G 区 | 不存在 | **未画** |

### 一句话状态

**连线已全对（含刚修好的 `GND`）**；剩下的都是"值没改 / 封装没改 / 还没画"，**没有新的硬伤**。打板仍然卡在 **D 区接线 + 封装对齐**这两条上。

---

## 九、2026-10-10 14:09 再导出版：D 区**接了一半**（接对的都对，漏的不少）

### ✅ 已进网表且**接法正确**

| 网表原文 | 判定 |
|---|---|
| `ISENSE_P ; C24.2 C28.2 Q2.3 R_gs2.1 R_shunt.2 U3.2` | ✅ **`COM`(2) → Q2 源极**，对 |
| `12V ; C5.2 C6.2 C9.2 C12.2 C14.2 C24.1 C28.1 L1.2 LED2.2 U1.4 U2.1 U3.3` | ✅ **`VCC`(3) → `12V`**，对 |
| `SW ; L3.1 Q1.3 Q2.2 R_gs1.1 U3.5` | ✅ **`VS`(5) → `SW`**，对 |
| `HO ; R_g1.2 U3.7` ／ `LO ; R_g2.2 U3.1` | ✅ 高/低端输出经栅极电阻，对 |
| **C24(100nF) + C28(10µF) 跨在 `12V`–`ISENSE_P`(COM) 之间** | ✅★ **这正是提醒过的关键点：`VCC` 去耦的**地端接 `COM`**、不是控制地** —— 做对了 |
| `24V` 仍 **10 脚**、`GND` 仍 **34 脚** | ✅ **没有新短路**；其余网与 12:56 版逐字相同 |
| `C11` 值 470µF → **10µF**、`C15/C16` 值 470uF → **10µF** | ✅ 值改过来了 |

### ❌ 漏掉 / 没做的（按重要性排序）

| # | 问题 | 证据 | 后果 |
|---|---|---|---|
| 1 | **`U3.13`(VSS) 没接** | `GND` 网 34 个脚里**没有 `U3.13`** | 逻辑侧没有参考地 → HIN/LIN/SD 全部无效 |
| 2 | **`U3.9`(VDD) 没接** | `5V` 网里**没有 `U3.9`** | 逻辑电源没供上 |
| 3 | **自举支路完全没建** | `U3.6`(VB) 不出现在任何网；**`D4` 一个网都没进** | 自举不充电 → **上管永远驱不动** |
| 4 | **U4（74HCT245）完全没接线** | `U4` 不在任何网里 | HIN/LIN/SD 没有来源 |
| 5 | **`C25`/`C26`/`C27`（100nF）、`C29`（10µF）悬空** | 只出现在 `$PACKAGES`，**不在任何网** | 摆了没用 |
| 6 | **245 A 侧 3 只 10 kΩ 没加** | BOM 里没有新电阻（只有 R1–R3、R_g、R_gs、R_shunt） | 上电期间 245 输入悬空 |
| 7 | **没有 `PWM_H`/`PWM_L`/`SD` 网络**，也没有 B 侧 `HIN`/`LIN`/`SD_D` | 全表 17 个网，均无 | — |

### 🟠 值 / 规格

- **`C11` 值只写 `10µF`，没有耐压** —— 它在 **24V 母线**上，必须写 **`10µF/50V`**（照现在这样选件会抓到 25V/16V 的）；BOM `No.5` 的 Manufacturer Part 仍是空。
- `C15/C16` 建议写全 `10µF/25V`。
- `C9/C10`、`C17–C20` 仍占位封装/未选料；`L1–L3` 仍是贴片电感封装；`U4` 仍是 TSSOP-20 —— 都属"打板才必须改"。

### 照这张表补完（剩下要连的）

| 元件·脚 | 连到 |
|---|---|
| `U3.13 VSS` | `GND`（控制地） |
| `U3.9 VDD` | `5V` ＋ **C25**(100nF) 到 `GND` |
| `U3.6 VB` | **C26**(100nF) ＋ **C29**(10µF) 的一端 ＋ **D4 阴极** |
| `U3.5 VS`（已接 `SW`） | C26 / C29 的**另一端**（**跨接 VB–VS**） |
| `D4` | 阴极 → `VB`(6)；**阳极 → `12V`**（⚠️ 极性**目视确认**，别按脚号猜） |
| `U3.10 HIN` | ← 245 **B0(18)**（网名 `HIN`） |
| `U3.12 LIN` | ← 245 **B1(17)**（网名 `LIN`） |
| `U3.11 SD` | ← 245 **B2(16)**（网名 `SD_D`） |
| `U4.1 DIR` | `5V` |
| `U4.2 / .3 / .4`（A0/A1/A2） | `PWM_H` / `PWM_L` / `SD` |
| `U4.5–9`（A3–A7） | `GND` |
| `U4.10 GND` | `GND` |
| `U4.11–15`（B3–B7） | **悬空** |
| `U4.19 /OE` | `GND` |
| `U4.20 VCC` | `5V` ＋ **C27**(100nF) 到 `GND` |
| 🆕 `R4` / `R5` | 10 kΩ：`PWM_H` / `PWM_L` → `GND` |
| 🆕 `R6` | 10 kΩ：`SD` → `3V3` |

> 🔴 **两条别踩**：
> 1. **245 的 A 侧与 B 侧不能挂同名网络标签**（A 侧叫 `SD`，B 侧就必须叫 `SD_D`；`PWM_H`/`PWM_L` 同理 → B 侧用 `HIN`/`LIN`）；
> 2. **`COM` 的走线点**：就近接 **Q2 源极引脚根部**，**不要接在 R_shunt 的焊盘上**（同网，但走线位置决定栅极脉冲电流会不会流经 R_shunt、污染采样）。

---

## 十、2026-10-10 14:24 再导出版：🔴 **`VB` 被接到 `SW` 上了 —— 自举被短路**

### 逐条读网表（第 56–69 行）

| 网络 | 成员 | 判定 |
|---|---|---|
| `ISENSE_P` | `C24.2 C28.2 Q2.3 R_gs2.1 R_shunt.2 U3.2` | ✅ `COM`(2) 正确 |
| `12V` | `… C24.1 C28.1 **D4.2** L1.2 … U3.3` | ✅ **`D4` 阳极 → `12V` 对**（按本库「脚1=阴极」，脚2=阳极） |
| `5V` | `… **C21.2** … **U3.9**` | ✅ **`VDD` 接上了**，C21（100nF）做 5V 去耦 |
| `GND` | **38 脚**（= 上版 34 + `C21.1` + `C26.1` + `C29.1` + **`U3.13`**） | ✅ **`VSS` 接上了** |
| `24V` | 仍 **10 脚** | ✅ **无新短路** |
| `HIN` / `LIN` / `SD_D` | `U3.10` ／ `U3.12` ／ `U3.11` —— **都是单脚网** | 🟡 网名建对了，但 **U4 那端还没接** |
| 🔴 **`SW`** | `C26.2 C29.2 D4.1 L3.1 Q1.3 Q2.2 R_gs1.1 U3.5 **U3.6**` | ❌ **`U3.6`(VB) 被并进了开关节点** |
| 🔴 **`GND`** | 含 **`C26.1` `C29.1`** | ❌ 自举电容的另一端接到了地上 |

### 错在哪（一条就够致命）

**`VB`(6) 和 `VS`(5) 现在是同一个网（`SW`）** → 自举电容两端电压恒为 **0** → **高边（上管）永远驱不动**。
同时 `C26`/`C29` 变成 `SW → GND` 的电容（等于跨在下管上），**不是自举电容**。

### 正确接法：新建一个 `VB` 网，**只放这 4 个成员**

```
12V ──▶|── D4 ──────┬──── VB (6)
                   │
        C26 (100nF) ┤
        C29 (10µF)  ┤
                    │
   SW ( = VS, pin5 )┘
```

| 成员 | 动作 |
|---|---|
| `U3.6`（VB） | **从 `SW` 上摘下来**，接到新的 `VB` 网 |
| `D4` 阴极（`D4.1`） | **从 `SW` 上摘下来**，接到 `VB`；阳极留在 `12V` ✅ |
| `C26` 一端 | **从 `GND` 上摘下来**，接到 `VB` |
| `C29` 一端 | **从 `GND` 上摘下来**，接到 `VB` |
| `C26` / `C29` 的**另一端** | 接 `VS`(5)，也就是 `SW` ✅（非极性电容，哪一端都行） |

> 验收标准：网表里应出现一个 **`VB` 网，成员恰好 = `U3.6` + `D4.1` + `C26.x` + `C29.x`**（4 个）；`GND` 里**不再有 C26/C29**；`SW` 里**不再有 `U3.6`**。

### ❌ 还未完成（与上轮相同）

| 项 | 状态 |
|---|---|
| **U4（74HCT245）** | **20 个脚一个都没接**（不在任何网里）；所以 `HIN`/`LIN`/`SD_D` 都是单脚网 |
| `PWM_H` / `PWM_L` / `SD` | 三个网**还不存在** |
| `C25` / `C27`（100nF） | **仍悬空**（只在 `$PACKAGES`） |
| `R4`/`R5`/`R6`（3×10 kΩ） | **没加** |
| `C11` 值 | 仍只写 `10µF`、无耐压、**无 Manufacturer Part** → 要写 `10µF/50V` 并选 1206 的 50V 件 |

---

## 十一、2026-10-10 14:29 再导出版：✅ **自举已修好，IR2110 十四个脚全部到位**

### 验收：逐字对上第十节的验收标准

| 网表原文 | 判定 |
|---|---|
| `VB ; C26.2 C29.2 D4.1 U3.6` | ✅✅ **成员恰好 4 个，与要求逐字一致**（`VB` 网只放 VB 脚 + 二极管阴极 + 两只自举电容一端） |
| `SW ; C26.1 C29.1 L3.1 Q1.3 Q2.2 R_gs1.1 U3.5` | ✅ **`U3.6` 已从 `SW` 摘除**；两只电容另一端落在 `VS`(5)/`SW`，正确 |
| `GND`（**36 脚**，上版 38） | ✅ **`C26.1`/`C29.1` 已从 `GND` 摘除** |
| `12V ; … D4.2 …` | ✅ 二极管**阳极 → 12V** 保持正确 |
| `24V` 仍 **10 脚** | ✅ 无新短路 |

**D 区 IR2110 侧至此 100% 完成** —— 14 个脚全部落实：

| 脚 | 1 LO | 2 COM | 3 VCC | 4 NC | 5 VS | 6 VB | 7 HO | 8 NC | 9 VDD | 10 HIN | 11 SD | 12 LIN | 13 VSS | 14 NC |
|---|---|---|---|---|---|---|---|---|---|---|---|---|---|---|
| 状态 | ✅ | ✅ | ✅ | ✅悬空 | ✅ | ✅ | ✅ | ✅悬空 | ✅ | ✅ | ✅ | ✅ | ✅ | ✅悬空 |

### 剩下的 = 只差 `U4`（74HCT245）+ 它的电容/电阻

| 项 | 目标状态 |
|---|---|
| `U4` 20 个脚 | 见第十二节逐脚表；接完后 `HIN`/`LIN`/`SD_D` 应从"单脚网"变成双端点 |
| 新增网络 `PWM_H` / `PWM_L` / `SD` | A 侧三个网（也与 R4/R5/R6 相连） |
| 新增网络 `3V3` | 只给 R6 上拉用（等 H 区画排针时接上核心板 3V3） |
| `C25` / `C27`（100nF） | 从悬空改为接 `5V`–`GND`（放 U4 旁），**或删掉多余的那颗**——别留悬空（DRC 会报） |
| `R4`/`R5`/`R6` | 3× 10 kΩ，见第十二节 |

### 接完 U4 后的**目标网表**（照这个自检）

| 网络 | 应该恰好是 |
|---|---|
| `PWM_H` | `R4.?` + `U4.2` |
| `PWM_L` | `R5.?` + `U4.3` |
| `SD` | `R6.?` + `U4.4` |
| `HIN` | `U3.10` + `U4.18` |
| `LIN` | `U3.12` + `U4.17` |
| `SD_D` | `U3.11` + `U4.16` |
| `GND` | 在现有 36 脚基础上 **再加 `U4.5 U4.6 U4.7 U4.8 U4.9 U4.10 U4.19`**（→ 43 脚） |
| `5V` | 再加 **`U4.1`（DIR）** 与 **`U4.20`（VCC）** |
| `3V3` | `R6.?`（暂只此一端，等 H 区排针） |
| `U4.11–U4.15`（B3–B7） | **不出现在任何网里**（悬空） |

---

## 十二、2026-10-10 14:51 再导出版：D 区**基本完工**，剩 `B0` 挂错网（🔴）+ 一处网名

### ✅ 接对的

| 网表原文 | 判定 |
|---|---|
| `5V ; … C21.2 C27.2 … U3.9 U4.1 U4.20` | ✅ `DIR`(1) 与 `VCC`(20) 都接 5V；C27 做 245 的去耦 |
| `GND` **46 脚**，新增 `C27.1 R4.2 R5.1 U4.5 U4.6 U4.7 U4.8 U4.9 U4.10 U4.19` | ✅ A3–A7 全部落地、`/OE` 接地、R4/R5 下拉到位 |
| `SW ; C25.1 C26.1 … U3.5` ／ `VB ; C25.2 C26.2 D4.1 U3.6` | ✅ 自举仍正确（**C29 换成了 C25**，10µF 那档，接法不变 —— 没问题） |
| `PWM_H ; R4.1 U4.2` ／ `PWM_L ; R5.2 U4.3` ／ `SD ; R6.2 U4.4` | ✅ A 侧三路 + 下拉/上拉全对 |
| `SD_D ; U3.11 U4.16` | ✅ `B2`(16) → `SD_D`，对 |
| `U4.11–U4.15` 不在任何网 | ✅ B3–B7 悬空，对 |
| `24V` 仍 10 脚 | ✅ 无新短路 |

### 🔴 错一处：`U4.18`(B0) 挂到了 `LIN` 网上

```
HIN ; U3.10                 ← 单脚网，没有驱动
LIN ; U3.12 U4.17 U4.18     ← B1 与 B0 两个输出被并在一起
```

**两个后果**：
1. **`HIN` 悬空** → IR2110 高边输入无信号（内部下拉 → 恒低）→ **上管永远不开**；
2. **`B0` 与 `B1` 两个输出短接** → `PWM_H`/`PWM_L` 是互补的，两路输出几乎总是相反 → **输出对顶**（可能烧 245，且电平不确定）。

**改法（一步）**：把 **`U4.18` 从 `LIN` 挪到 `HIN`**。

| 网络 | 改完应该是 |
|---|---|
| `HIN` | `U3.10` + **`U4.18`** |
| `LIN` | `U3.12` + `U4.17` |

> 对照：`B0`=**18** → `HIN`；`B1`=**17** → `LIN`；`B2`=**16** → `SD_D`。

### 🟠 两处小问题

| 项 | 现状 | 改成 |
|---|---|---|
| **`3.3V` 网名** | 网表里是 `'3.3V'` | 改成 **`3V3`**（与接口表登记名一致）—— 否则**画 H 区时排针上写 `3V3` 会变成两个互不相通的网** |
| **`C11` 值** | `10µF`，**无耐压、无 Manufacturer Part** | 改成 **`10µF/50V`** + 选 1206 的 50V X7R 件（它在 24V 母线上） |

### ⬜ 打板前才必须改的（老清单，未变）

`C9/C10`、`C17–C20`、`C12/C13/C14/C23` 仍是 `C0603` 占位；`L1`=`L0805`／`L2`,`L3`=`L0603` 仍是贴片电感封装；`U4` 仍是 TSSOP-20；`C1/C2` 封装名仍是 SMD。

### D 区完工判定

| 检查项 | 状态 |
|---|---|
| `U3`(IR2110) 14 脚 | ✅ **全部到位**（11 接 + 4/8/14 悬空） |
| `U4`(245) 20 脚 | 🟡 **只差 `U4.18` 挪一次**：改完即 A0/A1/A2 → `PWM_*`/`SD`、B0/B1/B2 → `HIN`/`LIN`/`SD_D`、A3–A7 与 `/OE` 接地、`DIR`/`VCC` 接 5V、B3–B7 悬空 |
| 自举 | ✅ `VB` 网恰好 4 个成员，`SW` 含 `VS`(5) |
| 下一步 | 改完即可按《D 区排布与接线要点》§7.5 的 5 条做**不接功率管**的上电验收 |

---

## 十三、2026-10-10 14:53 再导出版：✅ **D 区全部通过**（第十二节的两个问题都已改好）

### 逐网对上目标表

| 网络 | 本版成员 | 第十二节的问题 | 结果 |
|---|---|---|---|
| `HIN` | `U3.10 **U4.18**` | 之前 `U4.18` 挂在 `LIN` 上、`HIN` 单脚悬空 | ✅ **`B0`(18) 已挪回 `HIN`** |
| `LIN` | `U3.12 U4.17` | 之前 `U4.17` 与 `U4.18` 两个输出短接 | ✅ 只剩 `B1`(17) |
| `SD_D` | `U3.11 U4.16` | — | ✅ |
| `PWM_H` / `PWM_L` / `SD` | `R4.1 U4.2` ／ `R5.2 U4.3` ／ `R6.2 U4.4` | — | ✅ A 侧三路 + 下拉/上拉全对 |
| **`3V3`** | `R6.1`（**网名已是 `3V3`**，不再是 `3.3V`） | 之前叫 `'3.3V'` | ✅ **网名已统一** |
| `GND` | **46 脚**（含 `C27.1 R4.2 R5.1 U3.13 U4.5 U4.6 U4.7 U4.8 U4.9 U4.10 U4.19`） | — | ✅ |
| `5V` | 含 `C21.2 C27.2 U3.9 U4.1 U4.20` | — | ✅ |
| `SW` ／ `VB` | 7 脚 ／ **4 脚**（`C25.2 C26.2 D4.1 U3.6`） | — | ✅ 自举正确 |
| `24V` | **10 脚** | — | ✅ 无短路 |
| `U4.11–U4.15` | **不在任何网** | — | ✅ B3–B7 悬空 |

### D 区完工判定

| 检查项 | 状态 |
|---|---|
| `U3`（IR2110）14 脚 | ✅ **11 接 + 4/8/14 悬空** |
| `U4`（245）20 脚 | ✅ **15 接 + B3–B7 悬空** |
| 自举支路 | ✅ `VB` 网恰好 4 个成员（`VB`脚 + `D4`阴极 + `C25` + `C26`），`VS` 在 `SW` |
| 去耦分布 | ✅ VCC 组（12V↔COM）= `C24`/`C28`；VDD/245 组（5V↔GND）= `C21`/`C27`；自举 = `C25`(10µF)/`C26`(100nF) |
| 上电保护 | ✅ `PWM_H`/`PWM_L` 10 kΩ 下拉；`SD` 10 kΩ 上拉到 `3V3` |
| **结论** | ✅ **D 区可以收工**，可按《D 区排布与接线要点》§7.5 做"不接功率管"的上电验收 |

### 只剩这些（都不属于 D 区）

| 项 | 何时必须处理 |
|---|---|
| `C11` 值 `10µF` 无耐压、无 Manufacturer Part | **随时**（买件前写成 `10µF/50V`） |
| `C9/C10`、`C17–C20`、`C12/C13/C14/C23` 仍是 `C0603` 占位 | 打板前 |
| `L1`=`L0805`、`L2`/`L3`=`L0603` 仍是贴片电感封装 | 打板前 |
| `U4` 仍是 TSSOP-20（建议 DIP-20）、`C1/C2` 封装名仍是 SMD | 打板前 |
| **E / F / G 区未画**；**H / I 区未画** | **打板前必须** |

### 下一步建议

1. **D 区收工**——照 §7.5 做不接功率管的上电验收（也可留到洞洞板最小功率级时一起做）；
2. **接着画 E → F → G**：
   - **E 区（电压采样）**：`VOUT` 分压 + RC 滤波 → I 区排针。⚠️ **分压比仍卡在 ADC 量程**（数字控制侧尚未定 AD9226 模块 → 1 Vpp 还是 2 Vpp 决定比值）→ **先画结构、比值留待定**；
   - **F 区（电流采样 + 过流）**：`ISENSE_P`/`ISENSE_N` → INA180A2（G=50）→ LM393（5 V 供电、开集输出、**3V3 上拉 10 kΩ**）→ `FAULT_N`；阈值用 **3296 10 kΩ 多圈电位器**；
   - **G 区（输出测试）**：`VOUT` 输出端子 + 测试点 + 假负载接口；
3. 打板前的三个硬前提仍差：**E/F/G 画完**、**封装对齐实物**、**BOM 无空行**。

---

## 十四、2026-10-10 17:23 再导出版：✅ **E 区接线全部正确**（1 处改名 + 1 处选料）

### 逐条核对（对照《E 区排布与接线要点》§三 的 9 条）

| # | 应该 | 网表实际 | 判定 |
|---|---|---|---|
| 1 | `VOUT` → R7 一端 | `VOUT ; … L3.2 **R7.2**` | ✅ |
| 2 | R7 另一端 ＝ `VSENSE_DIV` ＝ 电位器 **1＋2 脚短接** | `$2N2 ; R7.1 R9.1 R9.2 R10.2` | ✅ **变阻器接法正确**（1、2 脚都在同一节点） |
| 3 | 电位器 **3 脚** → R8 | `$2N4 ; R8.2 R9.3` | ✅ |
| 4 | R8 另一端 → `GND` | `GND` 含 `R8.1` | ✅ |
| 5 | `VSENSE_DIV` → R10（1 kΩ） | `$2N2` 含 `R10.2` | ✅ |
| 6 | R10 另一端 ＝ `VSENSE` ＝ C30 ＋ D5 公共点 ＋ TP1 | `$2N3 ; C30.2 D5.3 R10.1 TP1.1` | ✅ |
| 7 | C30 另一端 → `GND` | `GND` 含 `C30.1` | ✅ |
| 8 | D5 公共点 → `VSENSE`；另两脚 → `GND` / `3V3` | `D5.3`∈`$2N3`、`D5.1`∈`GND`、`D5.2`∈`3V3` | ✅ **BAT54S 三脚全对**（脚 3 是公共点） |
| 9 | `VSENSE` → I 区 | 网络名还是自动名 **`$2N3`** | 🟠 **要改名成 `VSENSE`** |

**没有新短路**：`24V` 仍 10 脚；`GND` 从 46 → **49 脚**（= 46 + `C30.1` + `D5.1` + `R8.1`，数目对得上）；`VOUT`、`3V3`、`SW`、`VB`、`5V`、`12V` 全部正常。

### 要改的 3 处

| 项 | 现状 | 改成 |
|---|---|---|
| 🟠 **E 区输出网名** | 自动名 `$2N3` | **`VSENSE`** —— 否则以后 I 区排针上写 `VSENSE` 会变成**两个互不相通的网** |
| 🟠 **`C30` 的选料** | 值 `10nF/50V`，但 **Manufacturer Part 填的是 `178MU0002`（那是 100 nF 的件）**，立创编号空 | 用 **`C1710`**（三星 10nF/50V **0805**，Basic，库存 100 万+），**封装同时改 `C0805`**；或自行搜"10nF 50V 直插独石"（我没核到编号） |
| 📌 **位号与我文档不同** | 图纸：**电位器 = `R9`**、**1k 串联 = `R10`** | **以图纸为准**，《E 区排布与接线要点》已按图纸位号更正 |

### 仍未处理（老清单，未变）

`C11` 值只写 `10µF`（无耐压、无 Manufacturer Part）；`C9/C10`、`C17–C20`、`C12/C13/C14/C23` 仍是 `C0603` 占位；`L1`=`L0805`、`L2/L3`=`L0603` 仍是贴片电感封装；`U4` 仍是 TSSOP-20；`C1/C2` 封装名仍是 SMD。 —— **都属"打板前"**。

### 下一步

1. 改上面 3 处（**改名 1 秒；C30 换个件**）；
2. 接着画 **F 区（电流采样 + 过流）→ G 区（输出端子）**；
3. 打板三前提：**E/F/G 画完**、**封装对齐**、**BOM 无空行** —— E 区已从"未画"变成"已画完且核对通过"。

---

## 十五、2026-10-10 17:39 再导出版：✅ 封装改动**基本到位**（3 个小尾巴）

> ⚠️ **注意**：**封装改动只出现在 BOM 里，网表看不出封装** —— 所以本轮是"网表 + BOM 两张表对照"核的。

### ✅ 改对了（8 项）

| 项 | 结果 |
|---|---|
| **E 区输出网改名** | `VSENSE ; C29.2 D5.3 R10.1 TP1.1` ✅ **改名成功** |
| **10nF 那颗** | 位号 `C30` → **`C29`**，封装 `CAP-TH` → **`C0805`**，选料 ✅ **`C1710`**（三星） |
| **`C11` 耐压** | 值 → **`10uF/50V`** ✅（立创编号还空 🟢，MPN 已填 `TCC1206X7R106K500HT`） |
| **`C9/C10`** | `C0603` → **`C1206`**，选料 ✅ **`C6119987`** |
| **`C17–C20`** | `C0603` → **`C1206`**，选料 ✅ **`C12891`**（另**新增 `C22`** 一只 22µF） |
| **`L1`** | → **`IND-SMD_L7.1-W6.6_H5.0`**，选料 ✅ **`C2894721`** |
| **`L3`** | → **`IND-SMD_L11.5-W10.0_FXL1040`**，选料 ✅ **`C475915`** |
| **没有新短路** | `24V` 仍 **10 脚**；`GND` **49 脚**（`C29.1` 替 `C30.1`、`+C22.1`、`−C17.1`，**数目吻合**）✅ |

### 🟠 要修的 3 处

| # | 问题 | 证据 | 怎么改 |
|---|---|---|---|
| 1 | **`C17` 悬空** | `C17` 只出现在 `$PACKAGES`，**两个脚都不在任何网里**（`VOUT` 是 `…C18.2 C19.2 C20.2 C22.2…`、`GND` 是 `…C18.1 C19.1 C20.1 C22.1…`，都没有 `C17`） | 换封装时掉了线。**要么把 C17 并到 `VOUT`/`GND`，要么删掉它** —— `C22` 已经把容量补回来了（`VOUT` 仍 ≈108µF），**删掉不影响设计** |
| 2 | **BOM 位号写错** | `No.9` 的 Designator = **`C17,C17,C18,C19,C20`** —— **`C17` 重复、少了 `C22`** | 改成 `C17,C18,C19,C20,C22`（若删 C17 则 `C18,C19,C20,C22`） |
| 3 | **`L1` 的 1/2 脚对调** | `$1N17` 现在是 **`L1.2`**、`12V` 是 **`L1.1`**（原版是 `L1.1` 在开关节点） | **不用改**：**电感无极性**，电气上完全无害；这是换封装带来的脚序镜像，**记录备查**即可 |

### 🟡 还没做（打板前；**不挡 F 区**）

| 项 | 状态 |
|---|---|
| **`L2`** | 还是 `L0603`，33µH **未改、未选料** |
| **`C12` / `C13,C14` / `C23`** | 还是 `C0603`（680µF/220µF），**未改** |
| **`C1/C2`** | 还是 `CAP-SMD_…`（实物是直插 6×8），**未改** |
| **未选料** | `C25/C28`(10µF)、`C11` 的**立创编号**、`R4/R5/R6/R8`(**`C17414`**)、`R7`(**`C17621`**)、`R10`(**`C17513`**)、`R_gs1/2`(同 `C17414`)、`R1–R3`/`R_g`(走电阻包) |
| `U4` | TSSOP-20，**可选**（按你的焊接路线决定） |

### 结论：✅ **可以进 F 区**

这 3 个尾巴**不挡进度**（建议顺手改掉，1 分钟；也可以等 F/G 画完一起收）。**E 区确认收工。**

---

## 十六、2026-10-10 17:42 再导出版：**全量审计** —— ✅ 连线 100% 干净

> 本轮不是看变化，是**从头到尾把 29 个网、每个元件每一脚都过了一遍**。

### 一、两个强健康指标（最有力的证据）

| 指标 | 结果 |
|---|---|
| **有没有"单脚网"**（只有一个引脚的网络 = 断线／标签没连上） | ✅ **一个都没有** —— 29 个网**全部 ≥2 引脚** |
| **有没有"悬空元件"**（两个脚都不在任何网里） | ✅ **一个都没有** —— 28 只电容、10 只电阻、5 只二极管、3 只电感、4 只 IC、2 只 MOS、3 只 LED、J1/SW1/TP1 **全部有连接** |

### 二、29 个网逐条核（按功能分组）

| 功能组 | 网络 | 成员 | 判定 |
|---|---|---|---|
| A 区输入 | `$1N1` / `$1N20` | `J1.1 SW1.1` ／ `D1.1 SW1.2` | ✅ |
| U1 辅助 12V | `$1N17` | `D2.1 L1.2 U1.2` | ✅（`L1` 1/2 脚因换封装镜像，**电感无极性，无害**） |
| U2 辅助 5V | `$1N58` | `D3.1 L2.1 U2.2` | ✅ |
| 指示灯 | `$1N7` / `$1N19` / `$1N32` | LED1/2/3.1 + R1/2/3.2 | ✅ |
| 功率级栅极 | `$1N38` / `$1N44` | `Q1.1 R_g1.1 R_gs1.2` ／ `Q2.1 R_g2.1 R_gs2.2` | ✅ |
| 半桥 | `SW` | `C25.1 C26.1 L3.1 Q1.3 Q2.2 R_gs1.1 U3.5` | ✅ |
| 自举 | `VB` | `C25.2 C26.2 D4.1 U3.6` —— **恰好 4 个成员** | ✅ |
| 电流采样 | `ISENSE_P` | `C24.2 C28.2 Q2.3 R_gs2.1 R_shunt.2 U3.2` | ✅ |
| 驱动输出 | `HO` / `LO` | `R_g1.2 U3.7` ／ `R_g2.2 U3.1` | ✅ |
| 电平转换 | `PWM_H` / `PWM_L` / `SD` / `HIN` / `LIN` / `SD_D` | `R4.1+U4.2` ／ `R5.2+U4.3` ／ `R6.2+U4.4` ／ `U3.10+U4.18` ／ `U3.12+U4.17` ／ `U3.11+U4.16` | ✅ **A/B 侧不同名，没有互相短接** |
| 电压采样 | `$2N2` / `$2N4` / **`VSENSE`** | `R7.1 R9.1 R9.2 R10.2` ／ `R8.2 R9.3` ／ `C29.2 D5.3 R10.1 TP1.1` | ✅ `VSENSE` 网名已规范 |
| 电源轨 | `24V`(**10**) / `12V`(**13**) / `5V`(**12**) / `3V3`(2) | — | ✅ **无二极管混入、无重名合并** |
| 输出 | `VOUT` | `C15.2 C16.2 C18.2 C19.2 C20.2 C22.2 L3.2 R7.2` | ✅ 输出电容 = 10µF×2 + 22µF×4 = **108µF**，与设计一致 |
| 地 | `GND` | **49 脚** | ✅ 数目与元件清点吻合（见下） |

**`GND` 49 脚清点**：A 区 4（C1.2 C2.2 C3.1 C4.1）+ 12V/5V 去耦 8（C5–C12… 见网表）+ 输出/采样电容 + `R_shunt.1`（**星点**）+ U1 三脚 + U2 三脚 + U3.13 + U4 七脚 + D2/D3/D5 + R1–R5/R8 + J1.2 —— **逐项对上，无多无少**。

### 三、元件引脚覆盖检查（每个元件都点到了）

| 元件 | 覆盖 | 判定 |
|---|---|---|
| **U1 / U2**（LM2596） | 1 VIN、2 OUT、3 GND、4 FB、5 ON/OFF、6 GND-tab | ✅ **六脚全对**（FB 接输出、ON/OFF 接 GND） |
| **U3**（IR2110） | 已接 11 脚（1/2/3/5/6/7/9/10/11/12/13），**4/8/14 = NC 悬空** | ✅ **十四脚全对** |
| **U4**（245） | 已接 15 脚（1–10、16–20），**11–15 = B3–B7 悬空** | ✅ **二十脚全对** |
| **Q1 / Q2** | G(1)/D(2)/S(3) 全部有连接 | ✅ |
| **D1–D5** | 全部两／三脚有连接 | ✅ |
| **L1/L2/L3** | 两端都在网里 | ✅ |
| **C1–C29（除 C17）** | 全部两端有连接 | ✅（**C17 已按建议删除**） |
| **R1–R10、R_g1/2、R_gs1/2、R_shunt** | 全部两端有连接 | ✅ |

### 四、上一轮 3 个尾巴的处理结果

| 上轮问题 | 本版 | 判定 |
|---|---|---|
| `C17` 悬空 | **C17 已删除**（`$PACKAGES` 里 22µF 组变成 `C18 C19 C20 C22`） | ✅ 解决 |
| BOM 位号写成 `C17,C17,C18,C19,C20` | 现在是 **`4 | 22uF | C18,C19,C20,C22`** | ✅ 解决（数量 4 正确） |
| `L1` 1/2 脚对调 | 仍在（`L1.1`∈`12V`、`L1.2`∈`$1N17`） | ✅ 无害，**不用改** |

### 五、BOM 侧仍未做（**打板前**，不挡 F 区）

| 项 | 状态 |
|---|---|
| **`L2`** | 仍 `L0603`、33µH **未改未选料** |
| **`C12` / `C13,C14` / `C23`** | 仍 `C0603`（680µF / 220µF / 220µF-50V） |
| **`C1/C2`** | 仍 `CAP-SMD_…`（实物是直插 6×8） |
| **未选料** | `C25/C28`(10µF)、`C11` 与 `C15/C16` 的**立创编号**、`R4/R5/R6/R8`(**`C17414`**)、`R7`(**`C17621`**)、`R10`(**`C17513`**)、`R_gs1/2`(同 `C17414`)、`R1–R3`/`R_g`(走电阻包) |
| `U4`(TSSOP-20)、`D1`(SMA) | **可选**，按焊接路线决定 |

### 六、结论

> ✅ **连线层面 100% 干净**：29 个网、**零单脚网、零悬空元件、零短路**；U1/U2/U3/U4 的每一脚、以及全部 28 只电容 + 10 只电阻 + 5 只二极管 + 3 只电感都核过了。
> **可以放心进 F 区。** BOM 侧剩下的都是"打板前"要收的尾巴（**L2 / C12 / C13 / C14 / C23 / C1 / C2 的封装 + 几个编号**），**不挡 F 区**。

---

## 十七、2026-10-10 17:52 再导出版：封装 5 处**全改对**；但 `L2` 的值**单位写错了**

### ✅ 封装改动：5 处全部到位

| 位号 | 上一版 | 现在 | 判定 |
|---|---|---|---|
| **C12** | `C0603` | `CAP-TH_BD10.0-P5.00-D0.6-FD` | ✅ |
| **C13、C14** | `C0603` | `CAP-TH_BD6.3-P2.50-D0.6-FD` | ✅ |
| **C23** | `C0603` | `CAP-TH_BD8.0-P3.50-D0.6-FD` | ✅ |
| **C1、C2** | `CAP-SMD_BD6.3-…` | `CAP-TH_BD6.3-P2.50-D0.6-FD` | ✅ |
| **L2** | `L0603` | `IND-SMD_L7.1-W6.6_H5.0`（与 L1 同封装） | ✅ |

**`C0603` 那一组在网表里已经彻底消失** ✅ —— 说明 4 只 0603 电容全部换掉了。

### 🔴 `L2` 的值写错了：`33μF`（微法！）—— 而且编号对应的是 68µH

`BOM No.19`：`33μF | L2 | IND-SMD_L7.1-W6.6_H5.0 | 33μF | SXN(顺翔诺) | C2894721`

两个问题：
1. **单位写成了 `μF`（电容单位）**，应该是 **`μH`**；
2. **编号 `C2894721` 是 `SMMS0650-680M` = `68µH`**（就是 L1 那颗），**不是 33µH** —— 照这个买，L2 会买成第二颗 68µH。

**两条路选一条（推荐 A）：**

| 方案 | 怎么改 | 电气上 |
|---|---|---|
| **A（推荐）装 68µH** | 把 L2 的值改成 **`68µH`**，编号**保持 `C2894721`** → **L1/L2 同一颗料，买 2 只** | ✅ **完全没问题**：我们 B 区文档早就写了「**47–100µH 都行**，官方典型 33µH 是给 3A 负载的」；我们 5V 路负载 <0.2A、峰值 ≈0.57A，**用 68µH 纹波反而更小**（0.39A 峰峰 vs 0.79A），Isat 2A 富余 |
| B 保持 33µH | 值写成 **`33µH`**，**清掉 `C2894721`**，重新按「一体成型 / 33µH / Isat ≥1A / 7.1×6.6mm」选料 | ✅ 也完全可以，只是多一个料号 |

> ⚠️ **无论选哪个，`μF` 这个单位必须改掉** —— 值里写 `33μF` 会让人当成电容。

### ✅ 连线没被带坏

- `L2` 的 1/2 脚也对调了（`$1N58` 现含 `L2.2`、`5V` 含 `L2.1`）→ **与 L1 同一情况：电感无极性，无害**；
- 29 个网、**零单脚网**、`24V` 10 脚、`GND` 49 脚 —— **与上一版逐字相同** ✅。

### 🟡 还差这些编号没填（都是"粘贴一下"的事）

| 位号 | 填什么 |
|---|---|
| **C11** | 立创编号 **`C5449000`**（MPN 已有） |
| **C15、C16** | 立创编号 **`C19103847`**（MPN 已有） |
| **C25、C28** | MPN+编号：`CGA1206X7R106K250NT` ／ **`C6119987`** |
| **R4、R5、R6、R8** | **`C17414`** |
| **R7** | **`C17621`** |
| **R10** | **`C17513`** |
| **R_gs1、R_gs2** | **`C17414`**（可选） |
| **C12 / C13,C14 / C23** | 🟡 件还没选（按容值/耐压/Ø/脚距筛） |
| R1,R2 / R3 / R_g1,R_g2 | 走电阻包，**可不填** |
| U4 / D1 / TP1 | **不用填**（U4 走 SMT；D1 有编号；TP1 是焊盘） |

### 结论

**连线依然是 100% 干净**；封装 5 处全改对。**只剩 `L2` 的值改成 `68µH`（或换成 33µH 料）** + 几张"贴编号"的活。**F 区随时可以开始。**

---

## 十八、2026-10-10 19:31 再导出版：F 区**IC 接对了，但无源件支路一条都没接**

> ⚠️ **本轮的"单脚网"体检指标又立了功** —— 两个单脚网 + 5 个悬空元件，一眼定位。

### ✅ 接对的（F 区 IC 部分）

| 项 | 网表证据 | 判定 |
|---|---|---|
| **INA180A2（U5）五脚全对** | `ISENSE_P` 含 `U5.3`(IN+)；`GND` 含 `U5.2`(GND)、`U5.4`(IN−)；`5V` 含 `U5.5`(VS)；`ISENSE` 含 `U5.1`(OUT) | ✅ **Pinout A 接法完全正确** |
| **LM393 输出线与** | `FAULT_N ; U6.1 U6.7`（OUT1 + OUT2 线与） | ✅ |
| **LM393 输入极性正确** | `$2N15 ; R11.2 U6.3`（阈值在 `IN1+`）；`U6.2` 在 `ISENSE_F`（信号在 `IN1−`） | ✅ **这条最容易接反，接对了** |
| **OVP 走第二通道** | `VSENSE ; … U6.6`（`IN2−` ← `VSENSE`） | ✅ |
| **去耦** | `C31`(INA180)：5V/GND；`C32`(LM393)：5V/GND | ✅ |
| **上一轮的 `L2` 修好了** | `BOM No.19`：值 **`68µH`** + 编号 **`C2894721`** | ✅ 单位与料号都对了 |
| **`C11` 编号补上了** | `BOM No.5`：**`C5449000`** | ✅ |
| **R13/R14 选料** | `C17513`(1k) / `C17414`(10k) | ✅ |

### ❌ 漏接：**6 条支路，其中 2 条是单脚网、5 个元件完全悬空**

| # | 问题 | 网表证据 | 后果 |
|---|---|---|---|
| **1** | **`ISENSE` 是单脚网** | `'ISENSE' ; U5.1` —— **只有 INA180 的输出脚，没有别的** | INA180 输出**哪儿都没去**：既没进 R13，也没去 I 区 |
| **2** | **`ISENSE_F` 是单脚网** | `'ISENSE_F' ; U6.2` —— **只有比较器输入脚** | 比较器输入端没有信号 |
| **3** | **`R13` 完全悬空** | 全表 `$NETS` 里**没有 `R13`** | `ISENSE`→LM393 的滤波串联没接 |
| **4** | **`C30` 完全悬空** | `GND` 里**没有 `C30.1`**，其它网也没有 `C30` | 滤波电容没接 |
| **5** | **`R12` 完全悬空 + `R11.1`/`R11.3` 悬空** | 全表**没有 `R12`**；`R11` 只有 `R11.2`（滑臂）在 `$2N15` | **阈值支路没建**：电位器两端悬空、上限限流没接 → 滑臂电压浮动 → **保护阈值不确定** |
| **6** | **`R14` 完全悬空** | `3V3 ; D5.2 R6.1` —— **3V3 网里没有 R14**；全表也没有 `R14` | 🔴 **`FAULT_N` 没有上拉**！LM393 是**开集输出**，没上拉就永远给不出高电平 → FPGA 侧看到恒低 = **永远报过流**（或浮空不定） |
| **7** | **`U6.5`（`IN2+`）悬空** | 不在任何网 | 第二通道的阈值输入悬空 → **引脚不许悬空**；要开 OVP 就接阈值分压、不开就接 `GND` |

### 还差这些线（照这条补完）

| 从 | 到 |
|---|---|
| **`ISENSE`**（已含 `U5.1`） | → **`R13`** 一端；**同时**在 `ISENSE` 上放网络标签留给 I 区 |
| **`R13`** 另一端 | → **`ISENSE_F`**（已含 `U6.2`）→ 并接 **`C30`** 一端 |
| **`C30`** 另一端 | → **`GND`** |
| **`3V3`** | → **`R12`** 一端 |
| **`R12`** 另一端 | → **`R11.1`** |
| **`R11.3`** | → **`GND`** |
| **`FAULT_N`**（已含 `U6.1 U6.7`） | → **`R14`** 一端 |
| **`R14`** 另一端 | → **`3V3`** |
| **`U6.5`（`IN2+`）** | **要 OVP**：`3V3`→**`R15`(4.7 k)**→节点 `OVP_TH`→**`R16`(10 k)**→`GND`，`OVP_TH` 接 `U6.5`；<br>🔴 **不做 OVP：接 `3V3`（不是 `GND`！）** —— 本图 `U6.7` 已接 `FAULT_N`，若把 `IN2+` 接 `GND`，则 `IN2+ < IN2−`(`VSENSE`≈2 V) **恒成立 → 输出恒拉低 → `FAULT_N` 永久 = 0 = 永远报故障** ❌<br>（第三条路：把 `U6.7` 从 `FAULT_N` 上摘下来变成悬空，这时才可以让两个输入都接 `GND`） |

> ⚠️ **修正说明（2026-10-10 20:40）**：上一轮写"不做 OVP 就接 `GND`"是**按 `OUT2` 悬空**的前提写的；**本图 `OUT2` 已经线与到 `FAULT_N`**，所以正确做法是**接 `3V3`**（或摘掉 `U6.7`）。已在《F 区排布与接线要点》§四/§五 同步更正为"情形 A / 情形 B"两种。

### 补完后的自检（目标网表）

| 网络 | 应该恰好是 |
|---|---|
| `ISENSE` | `U5.1` + `R13.x`（+ I 区排针标签） |
| `ISENSE_F` | `R13.y` + `C30.x` + `U6.2` |
| `3V3` | `D5.2 R6.1` + **`R12.x`** + **`R14.y`**（+ 可选 `R15.x`） |
| `GND` | 现有 54 脚 + **`C30.y`** + **`R11.3`**（+ 可选 `R16`） |
| `FAULT_N` | `U6.1 U6.7` + **`R14.x`** |
| `$2N15`（阈值） | `R11.2` + `U6.3`（保持不变 ✅） |

### BOM 侧仍未做（**打板前**）

| 项 | 状态 |
|---|---|
| `C15/C16` 立创编号 | 🟢 还空（填 `C19103847`） |
| `C25/C28` | 🟡 无 MPN/编号（填 `CGA1206X7R106K250NT` / `C6119987`） |
| `R4/R5/R6/R8`、`R7`、`R10` | 🟡 无编号（`C17414` / `C17621` / `C17513`） |
| `C12` / `C13,C14` / `C23` | 🟡 封装已对，**件还没选** |
| `R_gs1/2`、`R1–R3`、`R_g1/2` | 🟡 走电阻包，可不填 |

### 结论

**F 区差最后 6 条线**（其中 **`FAULT_N` 的 10 k 上拉最要命** —— 少了它保护信号根本出不来）。**IC 部分（INA180A2 五脚 + LM393 输出线与 + 输入极性）已经全对**，补完上面那张表就收工。

---

## 十九、2026-10-10 19:45 再导出版：✅ **F 区全部完成，逐条核对通过**（含 OVP 通道）

### 一、上一轮 6 个漏接项 —— **全部接上**

| # | 上一轮问题 | 本版网表证据 | 结果 |
|---|---|---|---|
| 1 | `ISENSE` 单脚网 | `'ISENSE' ; R13.1 U5.1` | ✅ 接上 R13 |
| 2 | `ISENSE_F` 单脚网 | `'ISENSE_F' ; C30.2 R13.2 U6.2` | ✅ 三件齐 |
| 3 | `R13` 悬空 | 在 `ISENSE` / `ISENSE_F` 两个网里 | ✅ |
| 4 | `C30` 悬空 | `C30.2`∈`ISENSE_F`、**`C30.1`∈`GND`** | ✅ |
| 5 | `R12` 悬空 + `R11` 两端悬空 | `3V3` 含 `R12.1`；`'$2N26' ; R11.3 R12.2`；`GND` 含 `R11.1` | ✅ **阈值支路建成** |
| 6 | 🔴 `R14` 悬空（`FAULT_N` 无上拉） | `'FAULT_N' ; R14.1 U6.1 U6.7`；**`3V3` 含 `R14.2`** | ✅ **上拉修复** |
| 7 | `U6.5` 悬空 | `'$2N29' ; R15.2 R16.2 U6.5`；`3V3` 含 `R15.1`；`GND` 含 `R16.1` | ✅ **OVP 通道建成** |

### 二、逐条核（F 区完整清单）

| 项 | 证据 | 判定 |
|---|---|---|
| INA180A2（U5） | `U5.1`→`ISENSE`、`U5.2`→`GND`、`U5.3`→`ISENSE_P`、`U5.4`→`GND`、`U5.5`→`5V` | ✅ **Pinout A 五脚全对** |
| **过流阈值** | `3V3`→`R12.1`→`R12.2`→`R11.3`；`R11.1`→`GND`；`R11.2`(滑臂)→`U6.3` | ✅ 滑臂范围 **0 … 2.245 V** |
| **过流信号滤波** | `ISENSE`→`R13`→`ISENSE_F`(=`C30.2`+`U6.2`)；`C30.1`→`GND` | ✅ τ = 10 µs |
| **`FAULT_N` 上拉** | `U6.1`+`U6.7`+`R14.1`；`R14.2`→`3V3` | ✅ 开集上拉到位 |
| **OVP 阈值** | `3V3`→`R15.1`→`R15.2`(=`R16.2`=`U6.5`)→`R16.1`→`GND` | ✅ `OVP_TH` = 3.3 × 10/(4.7+10) = **2.245 V** |
| **OVP 信号** | `VSENSE ; … U6.6` | ✅ |
| **两路线与** | `U6.1` 与 `U6.7` 同在 `FAULT_N` | ✅ |
| 去耦 | `C31`(INA180)、`C32`(LM393) 跨 5V–GND | ✅ |
| **极性** | OCP：阈值在 `IN1+`、信号在 `IN1−`；OVP：阈值在 `IN2+`、信号在 `IN2−` | ✅ **两路极性一致 —— 正常时输出高阻、越限时拉低** |

**健康指标**：全表 **29 个网、零单脚网、零悬空元件**；`24V` 仍 10 脚；`GND` **57 脚**（上版 54 + `C30.1` + `R11.1` + `R16.1`，**数目吻合**）✅

### 三、OVP 动作点

`OVP_TH` = **2.245 V** → 因为 `VSENSE` 是 `VOUT` 的 0.4 倍分压 → **`VOUT` > 5.6 V 时 `FAULT_N` 拉低**（+12% 余量，正常 5 V 不会误触发）✅
正常时 `IN2+`(2.245 V) > `IN2−`(≈2.0 V) → **输出高阻，完全不影响 `FAULT_N`** ✅

### 四、两点备注（都不是错误）

1. **`R11` 的旋向与我文档写的相反**：我用 `1 脚→R12`、`3 脚→GND`；你用 **`3 脚→R12`、`1 脚→GND`**。**电位器两端互换 → 电气完全等价、滑臂范围一样（0–2.245 V）**，只是**顺时针/逆时针的升阈方向相反** —— 整定时注意往哪边拧是**升**阈值 ✅ 不用改；
2. **`3V3` 的负载**：`R6`(SD 上拉) + `R12` 支路(0.22 mA) + `R14` 上拉(≤0.33 mA) + `R15` 支路(0.22 mA) ≈ **0.8 mA** —— 远低于 3V3 的 100 mA 预算 ✅

### 五、BOM 侧仍未做（**打板前**，与 F 区无关）

| 项 | 状态 |
|---|---|
| `C15/C16` 立创编号 | 🟢 还空（填 `C19103847`） |
| `C25/C28` | 🟡 无 MPN/编号（填 `CGA1206X7R106K250NT` / `C6119987`） |
| **`R4/R5/R6/R8/R16`（10 K ×5）** | 🟡 无编号 → **`C17414`** |
| **`R12/R15`（4.7 K ×2）** | 🟡 无编号 → 走电阻包；要选料搜「0805 4.7kΩ 1%」 |
| `R7`(30 K) / `R10`(1 K) | 🟡 无编号 → `C17621` / `C17513` |
| `C12` / `C13,C14` / `C23` | 🟡 封装已对，**件还没选** |
| `R_gs1/2`、`R1–R3`、`R_g1/2` | 🟡 走电阻包，可不填 |

### 结论

✅ **F 区收工** —— 6 条漏接全补上，**连 OVP 通道一起建好了**，整区**零单脚网、零悬空**、极性全对。**可以进 G 区了。**

---

## 二十、2026-10-10 20:57 再导出版：**G 区 + H 区接线全部正确**；两个封装名要确认

### 一、G 区（输出与测试）—— 逐条对上

| # | 应该 | 网表证据 | 判定 |
|---|---|---|---|
| 1 | `VOUT` → `J2.1` | `VOUT ; … J2.1 …` | ✅ |
| 2 | `GND` → `J2.2` | `GND ; … J2.2 …` | ✅ |
| 3 | `VOUT` → `TP2.1` | `VOUT ; … TP2.1` | ✅ |
| 4 | `GND` → `TP2.2` | `GND ; … TP2.2` | ✅ |
| 5 | `VOUT` → `LED4.2`（阳极） | `VOUT ; … LED4.2 …` | ✅ |
| 6 | `LED4.1` → `R17` → `GND` | `'$1N109' ; LED4.1 R17.2` ＋ `GND` 含 `R17.1` | ✅ **与 LED1 同拓扑** |
| 7 | `R18` 跨 `VOUT`–`GND`（泄放） | `VOUT` 含 `R18.2`、`GND` 含 `R18.1` | ✅ |

> `J1,J2` 在 BOM 里合并成一行（2 只 `C55145024`）✅ 正确（同款端子）。

### 二、H 区（FPGA 排针）—— 逐条对上

| # | 应该 | 网表证据 | 判定 |
|---|---|---|---|
| 1 | `J3.1` = `PWM_H` → 245 A0 | `'PWM_H' ; J3.1 R4.1 U4.2` | ✅ |
| 2 | `J3.2` = `PWM_L` → 245 A1 | `'PWM_L' ; J3.2 R5.2 U4.3` | ✅ |
| 3 | `J3.3` = `SD` → 245 A2 | `'SD' ; J3.3 R6.2 U4.4` | ✅ |
| 4 | `J3.4` = `FAULT_N` | `'FAULT_N' ; J3.4 R14.1 U6.1 U6.7` | ✅ |
| 5 | `J3.5` = `ADC_CLK` | `'ADC_CLK' ; J3.5` | ✅（I 区未画，**单脚网属正常**） |
| 6 | `J3.6` = `PWM_TICK` → `TP3` | `'$2N38' ; J3.6 TP3.1` | ✅（区内节点，自动名可接受） |
| 7 | `J3.7`–`J3.18` = `ADC_D0`–`ADC_D11` | 12 个网各含 `J3.7`…`J3.18` | ✅（同上，**等 I 区**） |
| 8 | `J3.19` = `OTR` | `'OTR' ; J3.19` | ✅（等 I 区） |
| 9 | `J3.20` = `3V3` | `3V3 ; … J3.20 …` | ✅ |
| 10 | `J3.21`/`J3.22` = `GND` ×2 | `GND` 含 `J3.21 J3.22` | ✅ **按要求接了 2 根** |
| 11 | `J3.23`–`J3.26` = 备用 | **不出现在任何网** | ✅ 正确悬空 |

**健康指标**：`24V` 仍 **10 脚**；`GND` **63 脚**（上版 57 + `J2.2` + `J3.21` + `J3.22` + `R17.1` + `R18.1` + `TP2.2`，**数目吻合**）；`VOUT` 12 脚；`3V3` 6 脚 ✅

> ⚠️ **本版有 14 个"单脚网"（`ADC_CLK` + `ADC_D0…D11` + `OTR`）—— 这是正常的**，因为它们**另一端在 I 区（AD9226 模块）**，I 区画完后就会闭合。**这也是为什么"单脚网"这个体检指标要配合上下文看**。

### 三、两个封装名要确认

| 项 | 现状 | 要做什么 |
|---|---|---|
| **`J3` 的封装** | `CONN-TH_9001-35441C00A` ⚠️ 名称看不出针数 | **在封装管理器里点开看：必须是 26 个焊盘、2 列 × 13 行、行列间距都 2.54 mm、1 脚有标记**（截图里"检查封装尺寸"显示 **13 行**、焊盘 **1.524×1.524 mm** —— 这两个数字与 2×13 吻合 ✅，但仍请扫一眼焊盘总数是不是 **26**）。**这不确认就打板 = 26 根针插不进孔** |
| **`R18` 的封装** | **`QTH_R0805`** —— 与其它 0805 电阻的 `R0805` **不是同一个名字** | 建议**统一改成 `R0805`**（避免不同库的焊盘尺寸差异、也让 BOM 更干净）。若确认 `QTH_R0805` 也是标准 0805，可保留 |

### 四、BOM 仍未做（**打板前**）

| 项 | 状态 |
|---|---|
| `C15/C16` 立创编号 | 🟢 还空（填 `C19103847`） |
| `C25/C28` | 🟡 无 MPN（填 `CGA1206X7R106K250NT` / `C6119987`） |
| `R4/R5/R6/R8/R16`（10 K×5）· `R7`(30 K) · `R10/R17`(1 K) · `R12/R15`(4.7 K) | 🟡 无编号（`C17414` / `C17621` / `C17513`；4.7 K 走电阻包） |
| `C12` / `C13,C14` / `C23` | 🟡 封装已对，**件还没选** |
| `R_gs1/2`、`R1–R3`、`R_g1/2` | 🟡 走电阻包，可不填 |

### 结论

✅ **G 区、H 区接线全部正确**（8 个新增元件无一接错）；**只剩 I 区**。
⚠️ 打板前务必确认 **`J3` 的封装是 26 焊盘 2×13** + 顺手统一 **`R18` 的封装名**。

---

## 二十一、2026-10-10 21:05 再导出版：✅ **两处封装都改对了，H 区正式收工**

| 项 | 上一版 | 本版 | 判定 |
|---|---|---|---|
| **`J3` 封装** | `CONN-TH_9001-35441C00A`（名字看不出针数） | **`HDR-TH_26P-P2.54-V-M-R2-C13-S2.54-2`** | ✅✅ **名字里直接写了 `R2-C13` = 2 行 × 13 列 = 26 针** —— 比建议的 `-M-2` 版本更明确 |
| **`R18` 封装** | `QTH_R0805`（与其他 0805 电阻不同名） | **`R0805`** | ✅ 已统一 |

**用户中间踩掉的一个坑（记录备查）**：曾选中一个**单排 1×26** 的封装（预览是**一条直线**的 26 个焊盘）→ **判别诀窍：封装名末尾的 `-2` / `R2` 表示"2 排"，预览图应是"两条平行线"**。

### `$NETS` 逐字比对：**与上一版完全一致** ✅

- **51 个网**，`24V` 仍 **10 脚**、`GND` 仍 **63 脚**、`5V` 16、`12V` 13、`VOUT` 12、`3V3` 6 ✅
- **14 个单脚网**（`ADC_CLK` + `ADC_D0..D11` + `OTR`）= **等 I 区连接，属正常** ✅
- 本次改动**纯封装**，未触碰任何连线 ✅

### 🎯 状态

| 区 | 状态 |
|---|---|
| A / B / C / D / E / F / G / **H** | ✅ **八区全部画完 + 接线核对通过** |
| **I（AD9226 模块接口）** | ⏳ **只剩它** |

**H 区收工**。下一步：画 **I 区** → 九区齐活 → 进整板收尾（DRC → 封装终检 → BOM 补齐 → 打板）。

---

## 二十二、2026-10-10 21:49 再导出版：🎉 **九区齐活 —— 单脚网 14 → 0，连线 100% 干净**

> ⚠️ 中途插曲：用户 **21:34 那次导出与 21:05 版逐字节相同**（`J4/J5/J6/C33/C34` 一个都没出现）→ 定位为**导出前没保存**。已在《I 区文档 §三·补2》补上"**导出后先看文件体积**"的自查法（`.tel` 应 ~+600~900 字节）。

### 一、I 区逐条核 —— **全部正确** ✅

| # | 应该 | 网表证据 | 判定 |
|---|---|---|---|
| 1 | `ADC_D0` = `J3.7` + `J4.1` | `'ADC_D0' ; J3.7 J4.1` | ✅ |
| 2 | `ADC_D1`–`D11` = `J3.8–J3.18` + `J4.2–J4.12` | 逐条对上（`D1→J4.2`、`D2→J4.3`、`D3→J4.4`、`D4→J4.5`、`D5→J4.6`、`D6→J4.7`、`D7→J4.8`、`D8→J4.9`、`D9→J4.10`、`D10→J4.11`、`D11→J4.12`） | ✅ **12 根全对** |
| 3 | `OTR` = `J3.19` + `J4.13` | `'OTR' ; J3.19 J4.13` | ✅ |
| 4 | `ADC_CLK` = `J3.5` + `J4.14` | `'ADC_CLK' ; J3.5 J4.14` | ✅ |
| 5 | `VSENSE` 加 `J5.1` | `VSENSE ; C29.2 D5.3 J5.1 R10.1 TP1.1 U6.6` | ✅ |
| 6 | `ISENSE` 加 `J6.1` | `ISENSE ; J6.1 R13.1 U5.1` | ✅ |
| 7 | `5V` 加 `J4.16`+`C33.2`+`C34.2` | `5V` 共 **19 脚**（原 16 + 3） | ✅ |
| 8 | `3V3` 加 `J4.17` | `3V3` 共 **7 脚** | ✅ |
| 9 | `GND` 加 `J4.15`+`J4.18`+`J5.2`+`J6.2`+`C33.1`+`C34.1` | `GND` 共 **69 脚**（原 63 + 6） | ✅ **数目吻合** |
| 10 | `J4.19–J4.26` 留空 | 不出现在任何网 | ✅ |
| 11 | `J5.2`/`J6.2` = `GND` | 在 `GND` 网里 | ✅ |

### 二、🎉 全板连通性终检

| 指标 | 结果 |
|---|---|
| **网络总数** | **51** ✅ |
| 🔴 **"单脚网"** | **0**（画 I 区前是 **14** 个）✅✅ **判据达成** |
| **悬空元件** | **0** —— 全板 **86 个元件**（33 电容 + 23 电阻 + 5 二极管 + 3 电感 + 6 接插件/排针 + 4 LED + 2 MOS + 6 IC + SW1 + 3 测试点）全部有连接 ✅ |
| `24V` | **10 脚**（无短路）✅ |
| `GND` | **69 脚**（逐项清点吻合）✅ |
| `5V` / `3V3` / `12V` / `VOUT` | **19 / 7 / 13 / 12** ✅ |
| 其余各网 | 与上一版逐条一致 ✅ |

### 三、BOM 核（数量与合并都对）

| 行 | 内容 | 判定 |
|---|---|---|
| `No.17` | `2 | LAIL-PTB5.08-2P | J1,J2 | C55145024` | ✅ |
| `No.18` | `2 | **J3,J4** | HDR-TH_26P-P2.54-V-M-R2-C13-S2.54-2 | **C41430886**` | ✅ **I 区 J4 与 J3 同料，已合并** |
| `No.19` | `3 | **J5,J6,TP2** | HDR-TH_2P-P2.54-V-M-2 | **C2883961**` | ✅ **J5/J6 与 TP2 同料，已合并** |
| `No.3` | `11 | 100nF | …**C34** | C5632426` | ✅ C34 并入 |
| `No.4` | `3 | 10uF | C9,C10,**C33** | C6119987` | ✅ C33 并入 |

> 小备注：`SW1` 单独一行（Comment `HDR-M_2.54_2x1` 带下划线），与 `J5,J6,TP2`（`HDR-M-2.54_2x1` 带连字符）**料号相同、仅注释写法不同** → **不影响采购** ✅

### 四、🎯 阶段结论

| 区 | 状态 |
|---|---|
| **A / B / C / D / E / F / G / H / I —— 九个区** | ✅ **原理图全部画完 + 逐脚核对通过** |
| **整板连通性** | ✅ **51 网、零单脚网、零悬空、无短路** |

**「原理图完成」这一里程碑达成** ✅

### 五、接下来（打板前的整板收尾）

| # | 事情 | 状态 |
|---|---|---|
| 1 | **跑 DRC**（封装/引脚不匹配、未连接、短路） | ⏳ 待做 |
| 2 | **封装终检**（对照《封装与实物对照表》，实物都要能插上） | ⏳ 待做 |
| 3 | **BOM 补齐**（消灭空行，见下） | ⏳ 待做 |
| 4 | **PCB 布局 + 布线**（工作量大，还没开始） | ⏳ 待做 |
| 5 | Gerber 导出 + 下单打板（3–5 天） | ⏳ |

**BOM 仍缺的编号/选料**：
- 🟢 `C15/C16` 立创编号空 → `C19103847`
- 🟡 `C25/C28` 无 MPN → `CGA1206X7R106K250NT` / `C6119987`
- 🟡 `R4/R5/R6/R8/R16`(10 K×5) → `C17414`；`R7`(30 K) → `C17621`；`R10/R17`(1 K) → `C17513`；`R12/R15`(4.7 K) → 电阻包
- 🟡 `C12` / `C13,C14` / `C23` → **封装已对，件还没选**（按容值/耐压/Ø/脚距筛）
- 🟡 `R1,R2`/`R3`/`R_g1,R_g2`/`R_gs1,R_gs2` → 走电阻包，可不填

---

## 二十三、2026-10-10 22:45 再导出版：BOM 选料**填错了一列**，另有 2 处内容错、1 处漏填

> ✅ **先说好消息**：**没有任何封装被自动改掉**（我警告过的那个坑**没踩** ✅）；**连线一字未动**（`.tel` 仍 **4868 字节**，与上一版逐字节相同）。

### 🔴 问题 1：**9 处编号填到了「制造商编号」列，应该填在「供应商编号」列**

立创EDA 的两个字段：

| 字段 | 该填什么 | 立创下单时看哪个 |
|---|---|---|
| **「制造商编号」Manufacturer Part** | 厂商的型号（如 `0805W8F1001T5E`） | 参考 |
| **「供应商编号」Supplier Part** | **立创商城编号（`Cxxxxxxx`）** | ✅ **匹配元件看这个** |

**现在这 9 处把 `Cxxxxxxx` 填进了「制造商编号」**，而「供应商编号」是空的 → **下单时匹配不上，要手工处理**：

| 元件 | 现在（错列） | 应该 |
|---|---|---|
| `C12` | MPN = `C106522` | **供应商编号** = `C106522` |
| `C13,C14` | MPN = `C141282` | **供应商编号** = `C141282` |
| `C23` | MPN = `C2836445` | **供应商编号** = `C2836445` |
| `C15,C16` | MPN = `C19103847` ⚠️ **把原来的 `HGC0805R5106K250NSLJ` 覆盖了** | **供应商编号** = `C19103847`；**MPN 改回** `HGC0805R5106K250NSLJ` |
| `R7` | MPN = `C17621` | **供应商编号** = `C17621` |
| `R10,R17` | MPN = `C17513` | **供应商编号** = `C17513` |
| `R12,R15` | MPN = `C17673` | **供应商编号** = `C17673` |

> ✅ **这些编号的内容都是对的**（`C106522`/`C141282`/`C2836445`/`C17621`/`C17513`/`C17673`），**只是位置要挪**。

### 🔴 问题 2：`C25` / `C28` 填的**内容错了**

| 元件 | 现在 | 应该 |
|---|---|---|
| **`C25`** | `C19103847`（那是 **`C15/C16`** 的编号）❌ | **`C6119987`** |
| **`C28`** | `C17414`（那是 **10 kΩ 电阻**的编号！）❌ | **`C6119987`** |

（`C6119987` = `CGA1206X7R106K250NT` 10 µF/25V 1206 —— 与 `C25/C28` 的封装 `C1206`、值 `10μF` **正配** ✅，也和 `C9/C10/C33` 同款。）

### 🔴 问题 3：`R4/R5/R6/R8/R16`（10 K × 5）**还没填** → **`C17414`**

### 📌 怎么改最快

1. 选中元件 → 右侧**属性**面板 → 找 **「供应商编号」** → 粘贴 `Cxxxxxxx` → 回车（**MPN 会自动带出来**）；
2. **再回头看「制造商编号」** —— 如果那里还留着那个 `Cxxxxxxx`，**手动删掉**（或让它被自动带出的真 MPN 覆盖）；
3. 同类批量：`Ctrl` 多选（如 `C12` 单只、`C13`+`C14` 两只、`R12`+`R15` 两只）一起改；
4. **填完 `C25` 和 `C28` 都会是 `C6119987`** → BOM 里它们会**自动合并回一行**（现在是拆成两行，因为 MPN 不同）。

### ✅ 其他都对

| 项 | 判定 |
|---|---|
| **封装** | ✅ **一个都没被改掉**（`C12` 仍 `CAP-TH_BD10.0-P5.00`、`C13/C14` 仍 `BD6.3-P2.50`、`C23` 仍 `BD8.0-P3.50`、`C15/C16` 仍 `C0805`、`C25/C28` 仍 `C1206`、`J3/J4` 仍 `HDR-TH_26P-…R2-C13…`、`R7/R10/R12/R17` 仍 `R0805`） |
| **连线** | ✅ 网表逐字节不变（51 网、单脚网 0、悬空 0） |
| **BOM 行数** | 46 项（比上版 +1，因为 `C25`/`C28` 因 MPN 不同被拆成两行；改对后会合并回去） |
| `C15/C16`、`C18–C22`、`C29/C30`、`J3/J4`、`J5/J6/TP2` 等 | ✅ 编号齐全 |

### 结论

**连线 100% 干净、封装没被动过** ✅；**只差"把 9 处编号从 MPN 列挪到供应商编号列" + 改对 `C25`/`C28` + 补 `R4/R5/R6/R8/R16`**。

---

## 二十四、2026-10-10 22:51 再导出版：9 处挪列**全部做对** ✅，**只剩 2 处**

| 项 | 上一版 | 本版 | 判定 |
|---|---|---|---|
| `C12` 供应商编号 | （空） | **`C106522`** | ✅ |
| `C13,C14` | （空） | **`C141282`** | ✅ |
| `C23` | （空） | **`C2836445`** | ✅ |
| **`C15,C16`** | MPN 被覆盖成 `C19103847` | **MPN 改回 `HGC0805R5106K250NSLJ`** ＋ **供应商编号 `C19103847`** | ✅✅ **完全正确** |
| **`C25`** | `C19103847`（错） | **供应商编号 `C6119987`** | ✅ **改对了** |
| `R7` | （错列） | **`C17621`** | ✅ |
| `R10,R17` | （错列） | **`C17513`** | ✅ |
| `R12,R15` | （错列） | **`C17673`** | ✅ |
| **封装** | — | **一个都没被改掉** ✅ | ✅ |
| **连线** | — | `.tel` 仍 **4868 字节**、逐字节相同 | ✅ |

### 🔴 还剩 2 处

| 元件 | 现状 | 要改成 |
|---|---|---|
| **`C28`** | 供应商编号 = **`C17414`** ❌（那是 **10 kΩ 电阻**的编号！） | **`C6119987`** |
| **`R4`、`R5`、`R6`、`R8`、`R16`**（10 K × 5） | **供应商编号空白** ❌ | **`C17414`** |

> 改完后：`C25` 与 `C28` 都是 `C6119987` → 会在 BOM 里**自动合并回一行** ✅；`R4/R5/R6/R8/R16` 与 `R14`/`R18` 同料（`C17414`）但注释写法不同（`10K` vs `10kΩ`），**分行不影响采购** ✅

### 📌 一个"无伤大雅"的现状

那 7 处是**直接手填「供应商编号」**的，所以 **MPN 和厂商列是空的**（没走"选料"流程）：

- ✅ **对下单没影响** —— 立创/JLC 的 BOM 匹配**主要看 `Supplier Part`（`Cxxxxxxx`）**；
- 🟡 想让 MPN/厂商也自动补上，可以对这几个元件用「**选料**」重新绑一次（**可选，不做也行**）。

---

## 二十五、2026-10-10 22:53 再导出版：🎉 **BOM 完成（终检通过）**

| 上一轮剩的两处 | 本版 | 判定 |
|---|---|---|
| `C28` 供应商编号 = `C17414` ❌ | **`C6119987`**，且与 `C25` **合并成一行**（`C25,C28`，数量 2） | ✅ |
| `R4/R5/R6/R8/R16` 供应商编号空白 ❌ | **`C17414`** | ✅ |

### 全表终检

| 检查 | 结果 |
|---|---|
| **行数 / 元件数** | 46 行数据（`A1:J47`）；合计 **86 个元件**（33 电容 + 23 电阻 + 5 二极管 + 3 电感 + 8 连接器/排针 + 4 LED + 2 MOS + 6 IC + 2 测试点）= **与网表一致** ✅ |
| **`Supplier Part` 列** | 除「**走电阻包的**（`R1,R2`/`R3`/`R_g1,R_g2`/`R_gs1,R_gs2`）」和「**测试焊盘**（`TP1,TP3`）」外，**全部有值** ✅ |
| **封装列** | **逐行核对，一个都没被选料改掉** ✅（`C12` 仍 `BD10.0-P5.00`、`C13/C14` 仍 `BD6.3-P2.50`、`C23` 仍 `BD8.0-P3.50`、`C1/C2` 仍 `BD6.3-P2.50`、`J3/J4` 仍 `HDR-TH_26P-…R2-C13…`、`L1/L2` 仍 `IND-SMD_L7.1-W6.6_H5.0` …） |
| **连线** | `.tel` 仍 **4868 字节**、逐字节相同（51 网、单脚网 0、悬空 0）✅ |
| 备注 | `R4/R5/R6/R8/R16`（`10K`）与 `R14`/`R18`（`10kΩ`）**同料 `C17414` 但分行** —— 注释写法不同所致，**不影响采购** ✅ |

> 🎉 **「BOM 无空行」这个打板硬前提达成。**
> 唯一可选项：那 7 处直接手填编号的元件 **MPN/厂商列为空** —— 对下单无影响（匹配看 `Supplier Part`），想补可用「选料」重绑。

---

## 二十六、2026-10-11 16:30 版（`..._2026-10-11.tel/xlsx`）：D2/D3 换料 ✅ **但引脚号对调了 —— 必须确认极性** 🔴

### ✅ 做对的

| 项 | 上一版 | 本版 | 判定 |
|---|---|---|---|
| **`D2`,`D3`** | `1N5825` Microchip（贵）`C3758179`，封装 `DIO-TH_BD11.4-L8.9-P13.7-RD` | **`1N5822` MDD(辰达) `C2476`**，封装 **`DO-201AD_BD5.3-L8.4-P12.50-D1.4-FD`** | ✅ **正是推荐的方案** —— 便宜一个数量级，且换成**标准 DO-201AD**（本体 Ø5.3×8.4、脚距 12.5、引脚 Ø1.4） |
| 其余 | — | 逐行不变 | ✅ |
| 连线 | — | 51 网、单脚网 0、悬空 0、`24V` 10 脚、`GND` 69 脚 | ✅ |

### 🔴 但换料把 `D2`/`D3` 的**引脚号对调**了

| 网络 | 上一版 | 本版 |
|---|---|---|
| `$1N17`（开关节点，`L1`/`U1.2` 那侧） | `D2.**1**` | **`D2.2`** |
| `GND` | `D2.**2**` | **`D2.1`** |
| `$1N58`（开关节点，`L2`/`U2.2` 那侧） | `D3.**1**` | **`D3.2`** |
| `GND` | `D3.**2**` | **`D3.1`** |

**为什么危险**：`D2`/`D3` 是两颗 LM2596 的**续流二极管**，正确接法：
> **阴极（K，符号里的"横杠"端）→ 开关节点**；**阳极（A，三角形端）→ GND**

- 若**新符号脚序与旧符号相同**（脚 1 = 阴极）→ 现在成了 **阴极接 GND、阳极接开关节点 = 二极管反了** 🔴
  **后果**：`U1` 内部开关管一导通，`24V` 经反接的 `D2` **直通 GND** → **短路，炸二极管/炸电源** ❌❌
- 若新符号是 **1 = 阳极、2 = 阴极** → 现在反而**是对的** ✅

**→ 两种可能，取决于新符号脚序，不能猜，必须确认。**

### 🔧 确认方法（30 秒）

原理图上**选中 `D2`**，看符号：
1. 找到**三角形**和**横杠** —— 电流从三角形流向横杠 ⇒ **横杠端 = 阴极**；
2. 看**横杠端那个引脚的脚号**：

| 观察 | 结论 |
|---|---|
| 横杠端 = **脚 2**（现接 `$1N17`） | ✅ **对了，不用改** |
| 横杠端 = **脚 1**（现接 `GND`） | 🔴 **反了** —— 必须让「横杠端接 `$1N17`、三角形端接 `GND`」 |

> 最省事：**截一张 `D2` 附近的原理图给 硬件侧**，一眼可判。
> 改法：把 `D2`/`D3` 的两根连线对调（**横杠端必须接 `L1`/`U1.2` 那一侧**）；改完导网表，硬件侧核 `$1N17` 里的 `D2.x` 是不是阴极那一脚。

### ❌ `C18`–`C22`（22µF/25V）**还没换**

本版仍是 `CL31A226KAHNNNE`（三星）`C12891` —— **发货慢的那颗没动**。
→ 建议改成 **`C6119968`**（HRE 芯声 `CGA1206X5R226M250NT`，22µF/25V X5R 1206，**现货 112K+，5+ ¥0.61**）
> 注：`CL31A` 本身就是三星的 **X5R** 系列 → 换 X5R 替代**无性能退步**；封装仍是 `C1206`，**不用改封装**。

### 结论

**BOM/连线层面没有别的变化** ✅；**两件事**：① 🔴 **先确认 `D2`/`D3` 的阴极脚号**（关系到会不会炸）；② 把 `C18`–`C22` 换成 `C6119968`。

---

## 二十七、2026-10-11 16:48 版：`D2/D3` 极性**看图确认正确** ✅；`C18–C22` **又填错列（等于没换）** 🔴

### ✅ 一、`D2`/`D3` 极性 —— 已由原理图截图确认**正确**

用户提供 **A 区（电源输入）+ B 区（辅助电源）+ D 区（栅极驱动）** 三张原理图截图 → 逐项核对：

| 检查项 | 结果 |
|---|---|
| **`D1`**（SS54 防反） | 图上**三角形朝右（阳极在 `SW1` 侧）、横杠朝右（阴极在 `24V` 侧）** → ✅ **防反接正确** |
| **`D2`**（1N5822，`U1` 续流） | 图上**横杠在上（阴极）接开关节点、三角形在下（阳极）接 GND** → ✅ **正确** |
| **`D3`**（1N5822，`U2` 续流） | 同上 → ✅ **正确** |
| **`D4`**（UF4007 自举） | 图上**横杠在上（阴极）→ `VB`；三角形在下（阳极）→ `12V`** → ✅ **正确**（电流 `12V → VB`） |
| **`U3`(IR2110) 十四脚** | 引脚名/号与规格**完全吻合**（`LO1 COM2 VCC3 NC4 VS5 VB6 HO7 NC8 VDD9 HIN10 SD11 LIN12 VSS13 NC14`）；**三个 `NC`（4/8/14）都是 ×，正确未连接** ✅ |
| `U3` 各脚接线 | `COM→ISENSE_P`（跨 `C24/C28` 到 `12V`）✅、`VCC→12V` ✅、`VDD→5V`+`C21`(100nF)→GND ✅、`VSS→GND` ✅、`LO/HO/LIN/SD_D/HIN` 标签全对 ✅ |
| **A 区 / B 区全图** | `J1→SW1→D1→24V`、`C1/C2/C3/C4`、`U1`(LM2596-12) 六脚、`D2`、`L1`、`C14/C5/C6/C9`、`U2`(LM2596-5.0) 六脚、`D3`、`L2`(**68µH** ✅)、`C12/C13/C7/C8/C10`、`LED1–3` → **全部与网表一致** ✅ |

> ⭐ **重要认知修正**：硬件侧一开始从 D 区截图**误判"`C25`/`C26` 下端接到了 `12V`"**（以为是自举失效）。
> **但网表明确是 `SW ; C25.1 C26.1 L3.1 Q1.3 Q2.2 R_gs1.1 U3.5`** ✅ —— **自举电容接线完全正确，是 硬件侧看密集连线看走眼了**。
> **教训**：**密集连线的截图容易误判，网表（机器导出）才是权威**；看图只用来判断"符号极性/方向"这类网表看不出的信息。
> 另：`C25`/`C26` 在图上离 `U3` 较远，**画在一起更不容易误读**（PCB 布局仍要求紧贴 `U3`）。

### 🔴 二、`C18`–`C22`：`C6119968` **又填到了「制造商编号」列** → **等于没换**

`BOM No.9`：`4 | 22uF | C18,C19,C20,C22 | C1206 | 22uF | **C6119968**（这一列是制造商编号）| （厂商空）| **C12891**（这一列才是供应商编号）| LCSC`

→ **供应商编号还是 `C12891`（发货慢的那颗三星）** ❌ **下单时仍会按 `C12891` 匹配 = 白换**。

**修法**：把 `C6119968` 填到 **「供应商编号」** 列（**覆盖掉 `C12891`**）；「制造商编号」列让 EDA 自动带出（或清空）。

> ⚠️ **这两个字段已经错了三次了，记死这个规则**：
> | 字段 | 填什么 | 例 |
> |---|---|---|
> | **「制造商编号」Manufacturer Part** | **厂商型号** | `0805W8F1002T5E`、`CGA1206X5R226M250NT` |
> | **「供应商编号」Supplier Part** | **立创商城编号 `Cxxxxxxx`** | **`C6119968`** |
> **立创/JLC 下单匹配元件看的是「供应商编号」。填错列 → 原理图没问题，但下单会按旧料走。**

### 三、其余

网表与 16:32 版**逐字节相同** ✅（51 网、单脚网 0、悬空 0、`24V` 10 脚、`GND` 69 脚）；`D2`/`D3` 仍为 `1N5822` MDD `C2476`（封装 `DO-201AD_…`）✅；BOM 其余行不变 ✅。

### 结论

✅ **二极管极性四颗全部正确**（`D1`/`D2`/`D3`/`D4`）；**唯一要做的是把 `C6119968` 挪到「供应商编号」列、覆盖 `C12891`**。

---

## 二十八、2026-10-11 16:51 版：🎉 **BOM 收工**（`C18–C22` 已换对）

| 项 | 16:48 版 | 本版 | 判定 |
|---|---|---|---|
| `C18,C19,C20,C22` **供应商编号** | `C12891`（发货慢的三星）❌ | **`C6119968`**（HRE 芯声，现货 112K+，¥0.61）| ✅✅ **改对了 —— 下单会按新料匹配** |
| 制造商编号 | `C6119968`（填错列） | `CL31A226KAHNNNE`（旧三星型号）| 🟡 见下 |
| 网表 | — | 4904 字节、**逐字节不变**（51 网、单脚网 0、悬空 0、`24V` 10 脚、`GND` 69 脚）| ✅ |

### 🟡 唯一的小尾巴（**不影响下单**，可不改）

`C18–C22` 的 **「制造商编号」还留着旧三星型号 `CL31A226KAHNNNE`**，与新供应商编号（芯声 `C6119968` → `CGA1206X5R226M250NT`）**不匹配**：
- ✅ **对下单无影响** —— **JLC/立创匹配元件看「供应商编号」`C6119968`**；
- 🟡 但 BOM 读起来自相矛盾（型号写三星、料号是芯声），**建议清空那一格**（或让它自动带出 `CGA1206X5R226M250NT`）。

> 全表复查：**其余各行的 MPN 与供应商编号都一致** ✅（`C15/C16`=`HGC0805R5106K250NSLJ`+`C19103847`、`C9/C10/C33`=`CGA1206X7R106K250NT`+`C6119987`、`C11`=`TCC1206X7R106K500HT`+`C5449000`、`R13/R14/R18`=厚声系列、`D1`=`SS54`+`C7420369` …）

### 🏁 状态：**BOM 完成** —— 打板三前提只剩 PCB

| # | 前提 | 状态 |
|---|---|---|
| ① | **原理图九区齐活**（51 网、单脚网 0、悬空 0）| ✅ |
| ② | **封装对齐**（选料/换料都没改坏封装）| ✅ |
| ③ | **BOM 无空行 + 编号齐全** | ✅ **本次达成** |
| ④ | **PCB 布局布线** | ⏳ **唯一剩下的**（规划见《PCB布局规划-20261010.md》） |
