ShibainuQAQ/FPGA/03-EDA导出/BOM_Board1_PCB1_2026-10-11.xlsx

No. | Quantity | Comment | Designator | Footprint | Value | Manufacturer Part | Manufacturer | Supplier Part | Supplier
1 | 2 | 100uF | C1,C2 | CAP-TH_BD6.3-P2.50-D0.6-FD | 100uF | JVJ50V100M6x8 | JIERR(捷而瑞) | C46550415 | LCSC
2 | 2 | 10uF | C3,C4 | C1210 | 10uF | 1210B106K500NT | FH(风华) | C116808 | LCSC
3 | 11 | 100nF | C5,C6,C7,C8,C21,C24,C26,C27,C31,C32,C34 | CAP-TH_L5.8-W3.6-P5.0-D0.6 | 100nF | 178MU0002 | KNSCHA(科尼盛) | C5632426 | LCSC
4 | 3 | 10uF | C9,C10,C33 | C1206 | 10uF | CGA1206X7R106K250NT | HRE(芯声) | C6119987 | LCSC
5 | 1 | 10uF | C11 | C1206 | 10uF | TCC1206X7R106K500HT | CCTC(三环) | C5449000 | LCSC
6 | 1 | 680μF | C12 | CAP-TH_BD10.0-P5.00-D0.6-FD | 680μF |  |  | C106522
7 | 2 | 220μF | C13,C14 | CAP-TH_BD6.3-P2.50-D0.6-FD | 220μF |  |  | C141282
8 | 2 | 10µF | C15,C16 | C0805 | 10µF | HGC0805R5106K250NSLJ | Chinocera(华瓷) | C19103847 | LCSC
9 | 4 | 22uF | C18,C19,C20,C22 | C1206 | 22uF | CGA1206X5R226M250NT | HRE(芯声) | C6119968 | LCSC
10 | 1 | 220μF/50V | C23 | CAP-TH_BD8.0-P3.50-D0.6-FD | 220μF/50V |  |  | C2836445
11 | 2 | 10μF | C25,C28 | C1206 | 10μF |  |  | C6119987
12 | 2 | 10nF | C29,C30 | C0805 | 10nF | CL21B103KBANNNC | SAMSUNG(三星) | C1710 | LCSC
13 | 1 | SS54 | D1 | SMA_L4.3-W2.6-LS5.0-FD |  | SS54 | R+O(宏嘉诚) | C7420369 | LCSC
14 | 2 | 1N5822 | D2,D3 | DO-201AD_BD5.3-L8.4-P12.50-D1.4-FD |  | 1N5822 | MDD(辰达半导体) | C2476 | LCSC
15 | 1 | UF4007 | D4 | DO-41_BD2.4-L4.7-P8.70-D0.9-RD |  | UF4007 | MDD(辰达半导体) | C960666 | LCSC
16 | 1 | BAT54S | D5 | SOT-23_L2.9-W1.3-P1.90-LS2.4-BR |  | BAT54S | MDD(辰达半导体) | C408389 | LCSC
17 | 2 | LAIL-PTB5.08-2P-GN-01-ZC | J1,J2 | CONN-TH_2P-P5.08_LAIL-PTB5.08-2P-GN-01-ZC |  | LAIL-PTB5.08-2P-GN-01-ZC | 莱联 | C55145024 | LCSC
18 | 2 | 2541WV-2X13P | J3,J4 | HDR-TH_26P-P2.54-V-M-R2-C13-S2.54-2 |  | 2541WV-2X13P | HanElectricity(瀚源) | C41430886 | LCSC
19 | 3 | HDR-M-2.54_2x1 | J5,J6,TP2 | HDR-TH_2P-P2.54-V-M-2 |  |  |  | C2883961
20 | 1 | SMMS0650-680M | L1 | IND-SMD_L7.1-W6.6_H5.0 |  | SMMS0650-680M | SXN(顺翔诺) | C2894721 | LCSC
21 | 1 | 68μH | L2 | IND-SMD_L7.1-W6.6_H5.0 |  | 68μH | SXN(顺翔诺) | C2894721 | LCSC
22 | 1 | 10uH | L3 | IND-SMD_L11.5-W10.0_FXL1040 | 10uH | FXL1040-100-M | cjiang(长江微电) | C475915 | LCSC
23 | 4 | XL-502SURD | LED1,LED2,LED3,LED4 | LED-TH_BD5.9-P2.54-RD_RED |  | XL-502SURD | XINGLIGHT(成兴光) | C2895492 | LCSC
24 | 2 | IRLZ44N(UMW) | Q1,Q2 | TO-220-3_L10.2-W4.5-P2.54-L |  | IRLZ44N(UMW) | UMW(友台半导体) | C42370423 | LCSC
25 | 2 | 4.7K | R1,R2 | R0603 | 4.7K
26 | 1 | 1K | R3 | R0603 | 1K
27 | 5 | 10K | R4,R5,R6,R8,R16 | R0805 | 10K |  |  | C17414
28 | 1 | 30K | R7 | R0805 | 30K |  |  | C17621
29 | 2 | 10kΩ | R9,R11 | RES-ADJ-TH_3P-L10.0-W10.0-P2.50-L | 10kΩ | 3296W-1-103 | BOCHEN(博晨) | C118954 | LCSC
30 | 2 | 1K | R10,R17 | R0805 | 1K |  |  | C17513
31 | 2 | 4.7K | R12,R15 | R0805 | 4.7K |  |  | C17673
32 | 1 | 1kΩ | R13 | R0805 | 1kΩ | 0805W8F1001T5E | UNI-ROYAL(厚声) | C17513 | LCSC
33 | 1 | 10kΩ | R14 | R0805 | 10kΩ | 0805W8F1002T5E | UNI-ROYAL(厚声) | C17414 | LCSC
34 | 1 | 10k | R18 | R0805 | 10kΩ | 0805W8F1002T5E | UNI-ROYAL(厚声) | C17414 | LCSC
35 | 2 | 10Ω | R_g1,R_g2 | R0603 | 10Ω
36 | 2 | 10KΩ | R_gs1,R_gs2 | R0603 | 10KΩ
37 | 1 | 10mΩ | R_shunt | R2512 | 10mΩ | FMF25FPJR010-LH | PSA(信昌电陶) | C105366 | LCSC
38 | 4 | M3螺丝 | SCREW1,SCREW2,SCREW3,SCREW4 | M3螺丝
39 | 1 | HDR-M_2.54_2x1 | SW1 | HDR-TH_2P-P2.54-V-M-2 |  |  |  | C2883961
40 | 2 | Test-Point | TP1,TP3 | Test-Point-0.5mm
41 | 1 | LM2596HC5-12 | U1 | TO-263-5_L10.1-W8.7-P1.70-LS14.4-BR |  | LM2596HC5-12 | R+O(宏嘉诚) | C55111448 | LCSC
42 | 1 | LM2596SX-5.0/NOPB | U2 | TO-263-5_L10.2-W8.9-P1.70-TL |  | LM2596SX-5.0/NOPB | TI(德州仪器) | C10002 | LCSC
43 | 1 | IR2110PBF | U3 | DIP-14_L20.0-W7.6-P2.54-LS7.6-BL |  | IR2110PBF | Infineon(英飞凌) | C2967 | LCSC
44 | 1 | 74HCT245PW,118 | U4 | TSSOP-20_L6.5-W4.4-P0.65-LS6.4-BL |  | 74HCT245PW,118 | Nexperia(安世) | C5980 | LCSC
45 | 1 | INA180A2IDBVR | U5 | SOT-23-5_L3.0-W1.7-P0.95-LS2.8-BL |  | INA180A2IDBVR | TI(德州仪器) | C192764 | LCSC
46 | 1 | LM393N | U6 | DIP-8_L9.7-W6.4-P2.54-LS7.6-BL |  | LM393N | HGSEMI(华冠) | C725322 | LCSC
