ShibainuQAQ/FPGA/(commit log)

2026-10-31 FPGA fully-digital synchronous buck converter - public delivery snapshot 2026-11-01 (dirs 01-04; hardware process docs excluded)
    [BOM_Board1_PCB1_2026-10-11.xlsx]
2026-10-31 Add files via upload
    整理一下文件，最终的fpga代码部分
2026-10-31 Add files via upload
    上传实际测试内容
2026-10-31 重命名测试文件夹
2026-11-01 Update README.md
    更改了一个描述错误，将58ns的保护周期更改为10-15 ns
